Floriantoine/SPY-BOT/docs/img/rendu-3d.png

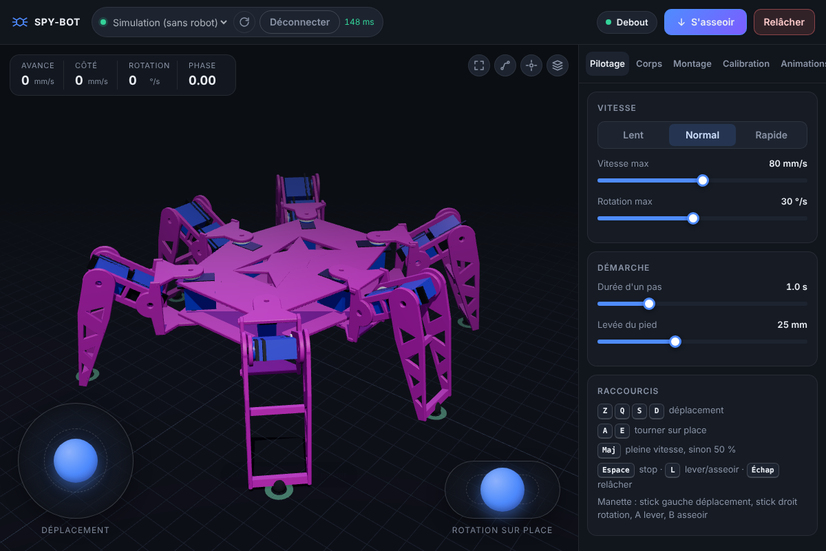
docs/img/rendu-3d.png
