Floriantoine/SPY-BOT/pc/web/models/corps.stl

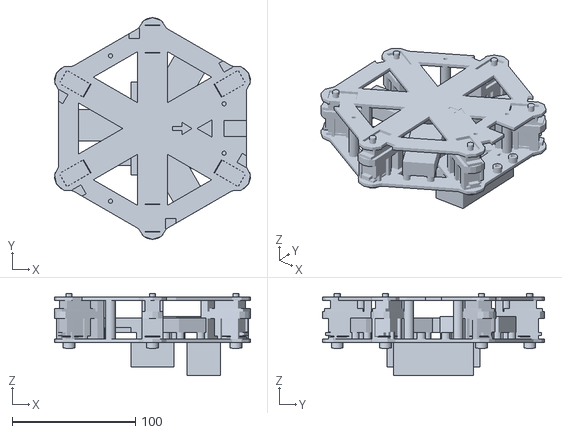
[picture p3: CAD file, 2026-11-03]
pc/web/models/corps.stl
158.8 x 179.8 x 66.6
