Floriantoine/SPY-BOT/pc/web/models/tibia.stl

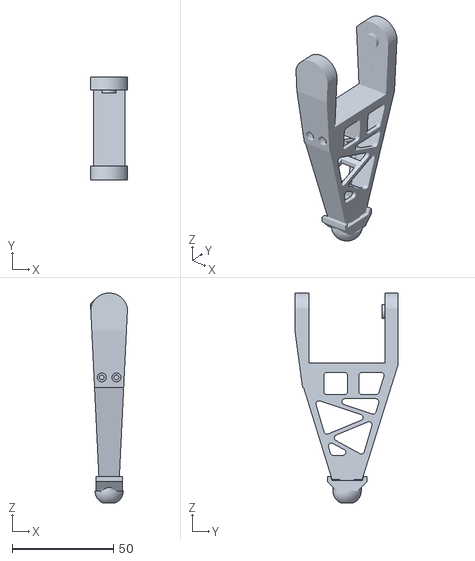
[picture p4: CAD file, 2026-11-02]
pc/web/models/tibia.stl
18.3 x 51.0 x 103.7
