Floriantoine/SPY-BOT/pc/web/models/coxa.stl

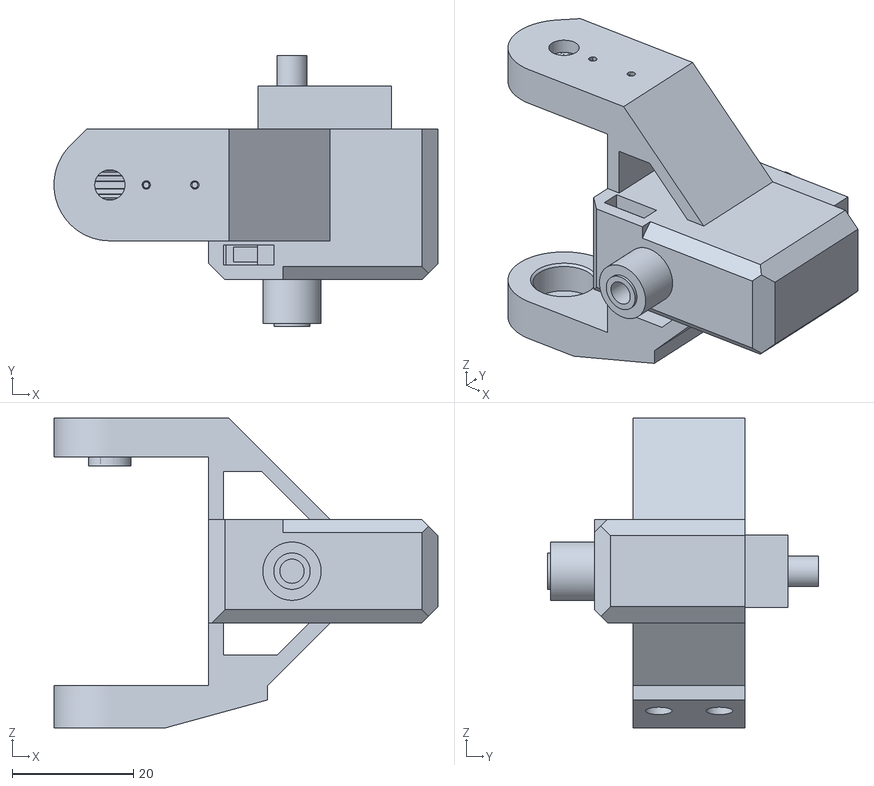
[picture p5: CAD file, 2026-11-02]
pc/web/models/coxa.stl
63.2 x 44.6 x 51.0
