Floriantoine/SPY-BOT/pc/web/models/femur.stl

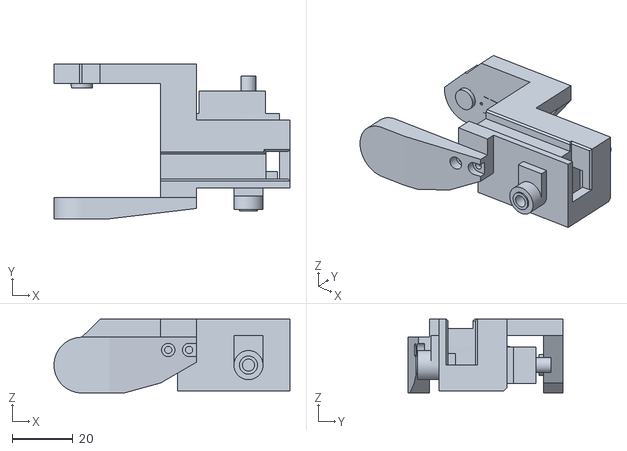
[picture p6: CAD file, 2026-11-02]
pc/web/models/femur.stl
77.9 x 51.0 x 24.4
