Floriantoine/SPY-BOT/docs/img/calibration.png

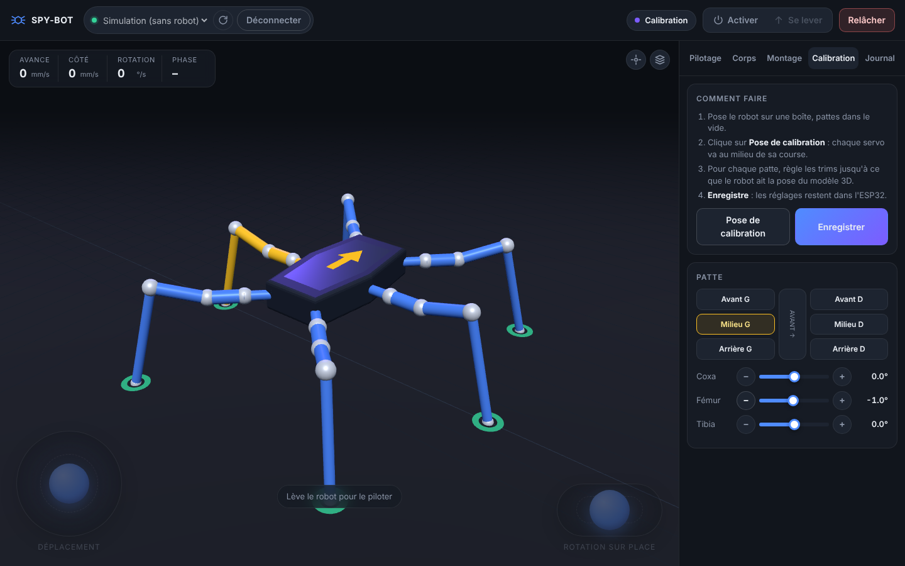
docs/img/calibration.png
