Floriantoine/SPY-BOT/firmware_c/src/robot.cpp

#include "robot.h"

#include <math.h>
#include <stdio.h>
#include <string.h>

#include "pyfmt.h"

// =============================================================================
// Servos et pattes (config.py, servo.py, robot._joint)
// =============================================================================

Leg g_legs[NLEGS];

void JointServo::refresh() {
    // robot._joint : d = 90 + direction × (deg - zéro) + trim, borné à [min, max] ± marge.
    double u = (min_deg + SERVO_MARGIN - 90.0 - trim_deg) / direction + zero_deg;
    double w = (max_deg - SERVO_MARGIN - 90.0 - trim_deg) / direction + zero_deg;
    lo_rad = (pymin(u, w) - 1e-9) / DEG_PER_RAD;
    hi_rad = (pymax(u, w) + 1e-9) / DEG_PER_RAD;
    k7 = 90.0 - direction * zero_deg + trim_deg;
    k8 = direction * DEG_PER_RAD;
    k9 = us_per_deg / US_PER_DEG - 1.0;
    k10 = 90.0 + trim_deg;
}

void legs_init() {
    for (int i = 0; i < NLEGS; i++) {
        Leg& leg = g_legs[i];
        leg.def = &CFG_LEGS[i];
        for (int j = 0; j < 3; j++) {
            const JointDef& d = CFG_LEGS[i].joint[j];
            JointServo& s = leg.joint[j];
            s.board = d.board;
            s.channel = d.channel;
            s.zero_deg = d.zero_deg;
            s.default_direction = s.direction = d.direction;
            s.trim_deg = 0.0;
            s.trim_is_int = false;
            s.min_deg = d.min_deg;
            s.max_deg = d.max_deg;
            s.us_per_deg = US_PER_DEG;
            s.refresh();
        }
    }
}

int leg_index(const char* name) {
    for (int i = 0; i < NLEGS; i++)
        if (strcmp(CFG_LEGS[i].name, name) == 0) return i;
    return -1;
}

double ik_to_servo_deg(double angle_rad, const JointServo& j) {
    double deg = 90.0 + j.direction * (angle_rad * SERVO_DEG_PER_RAD - j.zero_deg) + j.trim_deg;
    deg = pymax(j.min_deg, pymin(j.max_deg, deg));
    // Course réelle du servo : l'écart à la pose de calibration est mis à l'échelle.
    if (j.us_per_deg != US_PER_DEG) deg = deg + (deg - 90.0 - j.trim_deg) * (j.us_per_deg / US_PER_DEG - 1.0);
    return deg;
}

// =============================================================================
// Sauts de consigne adoucis (servo.py)
// =============================================================================

void soft_step(double e0, double w, double accel, double dt, double* e1, double* w1) {
    double d = e0 > 0.0 ? e0 : -e0;
    double s = e0 > 0.0 ? -1.0 : 1.0;
    double wd = w * s;  // vitesse d'approche en cours
    if (wd < 0.0) wd = 0.0;
    double cap = wd + accel * dt;
    double h = accel * dt / 2;
    double vc = sqrt(h * h + 2 * accel * d) - h;  // au-delà, plus moyen de freiner à temps
    double lin = d / dt;
    if (lin <= vc && lin <= cap) {
        *e1 = 0.0;  // arrivé à ce tick
        *w1 = s * lin;
        return;
    }
    *w1 = s * (vc < cap ? vc : cap);
    *e1 = e0 + *w1 * dt;
}

SmoothDriver::SmoothDriver(ServoDriver* inner)
    : accel(SLEW_DEG), busy(false), inner_(inner), walking_(false), fresh_(false) {
    memset(ch_, 0, sizeof(ch_));
}

void SmoothDriver::set_angle(int board, int channel, double deg) {
    Chan& c = ch_[board][channel];
    if (!c.valid) {
        // Position de départ inconnue (servo relâché) : rien à adoucir.
        c.x = c.p = c.xp = deg;
        c.w = 0.0;
        c.fresh = false;
        c.valid = true;
        inner_->set_angle(board, channel, deg);
        return;
    }
    c.x = deg;
    c.fresh = true;
    fresh_ = true;
}

bool SmoothDriver::lag(int board, int channel, double* p) const {
    const Chan& c = ch_[board][channel];
    if (!c.valid || c.p == c.x) return false;
    *p = c.p;
    return true;
}

void SmoothDriver::relax() {
    memset(ch_, 0, sizeof(ch_));
    busy = fresh_ = false;
    inner_->relax();
}

void SmoothDriver::flush(double dt, bool walking) {
    bool turn = walking != walking_;
    walking_ = walking;
    if (dt <= 0.0 || !(fresh_ || busy)) return;
    fresh_ = false;
    bool batch = inner_->has_batch();
    bool any = false;
    for (int b = 0; b < CFG_NBOARDS; b++) {
        bool dirty = false;
        for (int n = 0; n < 16; n++) {
            Chan& c = ch_[b][n];
            if (!c.valid) continue;
            double x = c.x, p = c.p, w = c.w, xp = c.xp;
            if (!c.fresh && p == x && w == 0.0) continue;  // sur sa consigne, qui n'a pas changé
            c.fresh = false;
            if (turn && w != 0.0) {
                double vt = (x - xp) / dt;
                w = walking ? w - vt : w + vt;
            }
            double e0 = walking ? p - xp : p - x;
            if (accel <= 0.0 || e0 == 0.0) {
                p = x;
                w = 0.0;
            } else {
                soft_step(e0, w, accel, dt, &e0, &w);
                p = x + e0;
            }
            if (p != x || w != 0.0) any = true;
            c.p = p;
            c.w = w;
            c.xp = x;
            dirty = true;
            if (!batch) inner_->set_angle(b, n, p);
        }
        if (dirty && batch) {
            // Voies qui se suivent : une seule écriture I²C.
            int start = -1, len = 0;
            double run[16];
            for (int n = 0; n < 16; n++) {
                if (!ch_[b][n].valid) continue;
                if (len && n != start + len) {
                    inner_->set_angles(b, start, run, len);
                    len = 0;
                }
                if (!len) start = n;
                run[len++] = ch_[b][n].p;
            }
            if (len) inner_->set_angles(b, start, run, len);
        }
    }
    busy = any;
}

// =============================================================================
// Cinématique inverse (leg_ik.py)
// =============================================================================

static char g_unreachable[96];

const char* unreachable_message() { return g_unreachable; }

bool leg_ik(double x, double y, double z, LegAngles* out) {
    static const double c = CFG_COXA, f = CFG_FEMUR, t = CFG_TIBIA;
    static const double k3 = f + t, k4 = fabs(f - t), k5 = f * f + t * t, k6 = 2 * f * t, k7 = f * f - t * t,
                        k8 = 2 * f;
    double r = sqrt(x * x + y * y) - c;
    double dd = r * r + z * z;
    double d = sqrt(dd);
    if (d > k3 || d < k4 || d == 0) {
        snprintf(g_unreachable, sizeof(g_unreachable), "pied hors de portée : (%.1f, %.1f, %.1f), d=%.1f", x, y, z, d);
        return false;
    }
    double cos_knee = (k5 - dd) / k6;
    double cos_shoulder = (k7 + dd) / (k8 * d);
    cos_knee = cos_knee < -1.0 ? -1.0 : cos_knee > 1.0 ? 1.0 : cos_knee;
    cos_shoulder = cos_shoulder < -1.0 ? -1.0 : cos_shoulder > 1.0 ? 1.0 : cos_shoulder;
    out->coxa = atan2(y, x);
    out->femur = atan2(z, r) + acos(cos_shoulder);
    out->tibia = acos(cos_knee) - PY_PI;
    return true;
}

// tibia_fold_limit - FOLD_MARGIN, en radians (robot._fold_limit_rad).
static double fold_limit_rad(double femur, bool middle) {
    double f0 = FOLD_RAD[0][0], t0 = FOLD_RAD[0][1];
    double v;
    if (femur <= f0) {
        v = t0;
    } else {
        v = FOLD_RAD[FOLD_POINTS - 1][1];
        for (int i = 1; i < FOLD_POINTS; i++) {
            double f1 = FOLD_RAD[i][0], t1 = FOLD_RAD[i][1];
            if (femur <= f1) {
                v = t0 + (t1 - t0) * (femur - f0) / (f1 - f0);
                break;
            }
            f0 = f1;
            t0 = t1;
        }
    }
    if (femur <= BATTERY_RAD[0] && v > BATTERY_RAD[1]) v = BATTERY_RAD[1];
    if (middle && femur <= STRAP_RAD[0] && v > STRAP_RAD[1]) v = STRAP_RAD[1];
    return v;
}

double leg_margin(const Leg& leg, const LegAngles& a) {
    const JointServo* c = &leg.joint[0];
    double worst = a.coxa - c->lo_rad;
    double v = c->hi_rad - a.coxa;
    if (v < worst) worst = v;
    c = &leg.joint[1];
    v = a.femur - c->lo_rad;
    if (v < worst) worst = v;
    v = c->hi_rad - a.femur;
    if (v < worst) worst = v;
    c = &leg.joint[2];
    v = a.tibia - c->lo_rad;
    if (v < worst) worst = v;
    v = c->hi_rad - a.tibia;
    if (v < worst) worst = v;
    double fold = fold_limit_rad(a.femur, leg.def->middle) + a.tibia + K_HALF_PI;
    worst = worst * DEG_PER_RAD + SERVO_MARGIN;
    fold = fold * DEG_PER_RAD + FOLD_MARGIN;
    return fold < worst ? fold : worst;
}

bool leg_ok(const Leg& leg, const LegAngles& a) {
    const JointServo* c = &leg.joint[0];
    double v = a.coxa;
    if (v < c->lo_rad || v > c->hi_rad) return false;
    c = &leg.joint[1];
    double femur = a.femur;
    if (femur < c->lo_rad || femur > c->hi_rad) return false;
    c = &leg.joint[2];
    v = a.tibia;
    if (v < c->lo_rad || v > c->hi_rad) return false;
    if (femur <= K_MINUS_HALF_PI || -v - K_HALF_PI > fold_limit_rad(femur, leg.def->middle)) return false;
    // Fémur levé : la coxa doit moins tourner (bord de la plaque du haut).
    return femur <= RAD_45 || fabs(a.coxa) <= RAD_55 - (femur - RAD_45) / 3.0;
}

bool neighbours_ok(const AngleSet& angles) {
    for (int i = 0; i < NLEGS; i++) {
        int n = CFG_AROUND[i], m = CFG_AROUND[(i + 1) % NLEGS];
        if ((angles.leg[n].coxa - angles.leg[m].coxa) * DEG_PER_RAD > NEIGHBOUR_LIMIT) return false;
    }
    return true;
}

// =============================================================================
// Corps (body_ik.py)
// =============================================================================

struct Rot {
    double m[3][3];
};

static Rot rotation(double roll, double pitch, double yaw) {
    double cr = cos(roll), sr = sin(roll);
    double cp = cos(pitch), sp = sin(pitch);
    double cy = cos(yaw), sy = sin(yaw);
    Rot r = {{{cy * cp, cy * sp * sr - sy * cr, cy * sp * cr + sy * sr},
              {sy * cp, sy * sp * sr + cy * cr, sy * sp * cr - cy * sr},
              {-sp, cp * sr, cp * cr}}};
    return r;
}

// Pied dans le repère du corps déplacé (foot_in_body), puis de la patte (body_to_leg_frame).
static void foot_to_leg(const double foot[3], const BodyPose& pose, const Rot& r, int leg, double out[3]) {
    double dx = foot[0] - pose.x, dy = foot[1] - pose.y, dz = foot[2] - pose.z;
    double bx = r.m[0][0] * dx + r.m[1][0] * dy + r.m[2][0] * dz;
    double by = r.m[0][1] * dx + r.m[1][1] * dy + r.m[2][1] * dz;
    double bz = r.m[0][2] * dx + r.m[1][2] * dy + r.m[2][2] * dz;
    const LegDef& d = CFG_LEGS[leg];
    double ex = bx - d.mount_x, ey = by - d.mount_y;
    double c = d.cos_a, s = d.sin_a;
    out[0] = c * ex + s * ey;
    out[1] = -s * ex + c * ey;
    out[2] = bz;
}

// =============================================================================
// Réserve d'AngleSet
// =============================================================================

AngleSet* AnglePool::alloc() {
    for (int i = 0; i < SLOTS; i++) {
        bool used = false;
        for (int h = 0; h < nholders_ && !used; h++) used = *holders_[h] == &slots_[i];
        if (!used) return &slots_[i];
    }
    return &slots_[0];  // n'arrive pas : moins de détenteurs que de cases
}

// =============================================================================
// Démarches (gait.py)
// =============================================================================

void TripodGait::advance(double dt, bool moving) {
    double new_phase = phase + dt / period;
    if (!moving) {
        if (at_rest()) return;
        new_phase = pymin(new_phase, phase < 0.5 ? 0.5 : 1.0);
    }
    phase = pymod(new_phase, 1.0);
}

double TripodGait::swing(int leg) const {
    double p = CFG_LEGS[leg].tripod_a ? phase : pymod(phase + 0.5, 1.0);
    return p < 0.5 ? p / 0.5 : -1.0;
}

double TripodGait::time_to_lift(int leg) const {
    double p = CFG_LEGS[leg].tripod_a ? phase : pymod(phase + 0.5, 1.0);
    return (1.0 - p) * period;
}

bool WaveGait::at_rest() const {
    double q = phase * 6;
    return fabs(q - (double)pyround(q)) < 1e-9;
}

void WaveGait::advance(double dt, bool moving) {
    if (!moving && at_rest()) return;
    double new_phase = phase + dt / period;
    if (!moving) {
        // Arrêt au prochain sixième : tous les pieds au sol.
        new_phase = pymin(new_phase, (double)((long long)(phase * 6 + 1e-9) + 1) / 6.0);
    }
    phase = pymod(new_phase, 1.0);
    if (fabs(phase - 1.0) < 1e-9) phase = 0.0;
}

double WaveGait::swing(int leg) const {
    double w = swing_part();
    double u = pymod(phase - (double)CFG_LEGS[leg].wave_rank / 6, 1.0);
    return u < w - 1e-9 ? u / w : -1.0;
}

double WaveGait::time_to_lift(int leg) const {
    double u = pymod(phase - (double)CFG_LEGS[leg].wave_rank / 6, 1.0);
    return (1.0 - u) * period;
}

double QuadGait::swing_part() const { return (1.0 - QUAD_SHIFT) / 4; }

bool QuadGait::at_rest() const {
    double q = phase * 4;
    return fabs(q - (double)pyround(q)) < 1e-9;
}

void QuadGait::reset() {
    phase = 0.0;
    slot = 0;
    has_target = false;
    shift_x = shift_y = from_x = from_y = 0.0;
}

void QuadGait::advance(double dt, bool moving) {
    if (!moving && at_rest()) {
        // Arrêté : le corps revient doucement au centre, pieds au sol.
        double step = 60.0 * dt;
        double x = shift_x, y = shift_y;
        double n = sqrt(x * x + y * y);
        double k = n != 0.0 ? pymax(0.0, n - step) / n : 0.0;
        shift_x = from_x = x * k;
        shift_y = from_y = y * k;
        return;
    }
    double new_phase = phase + dt / period;
    if (!moving) {
        // Arrêt au prochain quart : tous les pieds au sol.
        new_phase = pymin(new_phase, (double)((long long)(phase * 4 + 1e-9) + 1) / 4.0);
    }
    phase = pymod(new_phase, 1.0);
    if (fabs(phase - 1.0) < 1e-9) phase = 0.0;
    int s = (int)((long long)(phase * 4 + 1e-9) % 4);
    if (s != slot || !has_target) {
        slot = s;
        from_x = shift_x;
        from_y = shift_y;
        planner->plan_sway(s, &target_x, &target_y);
        has_target = true;
    }
    double u = pymin(1.0, pymax(0.0, phase * 4 - s));
    if (u < QUAD_SHIFT) {
        double q = u / QUAD_SHIFT;
        q = q * q * (3 - 2 * q);
        shift_x = from_x + (target_x - from_x) * q;
        shift_y = from_y + (target_y - from_y) * q;
    } else {
        shift_x = target_x;
        shift_y = target_y;
    }
}

double QuadGait::swing(int leg) const {
    int idx = CFG_LEGS[leg].quad_rank;
    if (idx < 0) return -1.0;  // patte repliée : gérée par Hexapod
    double w = swing_part();
    double u = pymod(phase - (idx + QUAD_SHIFT) / 4, 1.0);
    return u < w - 1e-9 ? u / w : -1.0;
}

double QuadGait::time_to_lift(int leg) const {
    double u = pymod(phase - (CFG_LEGS[leg].quad_rank + QUAD_SHIFT) / 4, 1.0);
    return (1.0 - u) * period;
}

// =============================================================================
// PROF
// =============================================================================

const char* const PROF_NAMES[PROF_PARTS] = {"capteur", "gyro", "i2c", "ik", "pieds", "place", "servos", "telem", "tick", "update"};
Profiler g_prof;

void Profiler::add(int part, unsigned long t0) {
    us[part] += platform_micros() - t0;
    used[part] = true;
}

struct ProfScope {
    int part;
    unsigned long t0;
    explicit ProfScope(int p) : part(p), t0(g_prof.on ? platform_micros() : 0) {}
    ~ProfScope() {
        if (g_prof.on) g_prof.add(part, t0);
    }
};

// =============================================================================
// Hexapod (robot.py)
// =============================================================================

static double py_sq(double v) { return pow(v, 2.0); }  // v ** 2 de Python

static double rate(double value, double target, double accel, double decel) {
    // Freinage (vers zéro, ou changement de sens) plus fort que l'accélération.
    return (value * target > 0 && fabs(target) > fabs(value)) ? accel : (value != 0.0 ? decel : accel);
}

static double approach(double value, double target, double step) {
    if (value < target) return pymin(target, value + step);
    return pymax(target, value - step);
}

static double fraction_inside(double x, double y, double mx, double my, double radius) {
    if (py_sq(x + mx) + py_sq(y + my) <= radius * radius) return 1.0;
    double a = mx * mx + my * my;
    double b = 2 * (x * mx + y * my);
    double c = x * x + y * y - radius * radius;
    if (c >= 0) return b <= 0 ? 1.0 : 0.0;
    return pymax(0.0, pymin(1.0, (-b + sqrt(b * b - 4 * a * c)) / (2 * a)));
}

Hexapod::Hexapod(ServoDriver* d, AnglePool* p) : driver(d), pool(p) {
    tripod.period = GAIT_PERIOD;
    tripod.step_height = TRIPOD_STEP_HEIGHT;
    tripod.max_stride = TRIPOD_MAX_STRIDE;
    tripod.phase = 0.0;
    tripod.shift_x = tripod.shift_y = 0.0;
    for (int i = 0; i < NLEGS; i++) {
        neutral[i][0] = CFG_LEGS[i].neutral_x;
        neutral[i][1] = CFG_LEGS[i].neutral_y;
        neutral[i][2] = CFG_LEGS[i].neutral_z;
    }
    // À 4 pattes, le corps se balance en plus du pas (réglages de robot.py).
    gait4.period = QUAD_PERIOD;
    gait4.step_height = QUAD_STEP_HEIGHT;
    gait4.max_stride = QUAD_MAX_STRIDE;
    gait4.sway = QUAD_SWAY;
    gait4.planner = this;
    gait4.target_x = gait4.target_y = 0.0;
    gait4.reset();
    // Vague : chaque patte fait son pas à tour de rôle, cycle deux fois plus long.
    wave.period = WAVE_PERIOD;
    wave.step_height = TRIPOD_STEP_HEIGHT;
    wave.max_stride = TRIPOD_MAX_STRIDE;
    wave.phase = 0.0;
    wave.shift_x = wave.shift_y = 0.0;
    wave_mode = WAVE_OFF;
    wave_speed = WAVE_SPEED;
    wave_key_valid_ = false;
    wave_shift = shift_mm_ = WAVE_SHIFT;
    shift_amp_ = 0.0;
    shift_dir_[0] = shift_dir_[1] = 0.0;
    sag = SAG_DEG;
    sag_rad = SAG_DEG * DEG;
    sag_k = 1.0;
    for (int i = 0; i < NLEGS; i++) load[i] = 1.0;
    load_settled_ = true;
    six = &tripod;
    gait = &tripod;
    legs = 6;
    tuck = 0.0;
    command = current = gait_command();
    pose = base_pose = applied = body_pose();
    pose_scale = lift_scale = 1.0;
    memset(offsets, 0, sizeof(offsets));
    memset(lift_, 0, sizeof(lift_));
    memset(has_lift_, 0, sizeof(has_lift_));
    rest_key_valid_ = false;
    rest_key_gait_ = NULL;
    rest_key_legs_ = 0;
    rest_key_phase_ = 0.0;
    memset(ground, 0, sizeof(ground));
    memset(ground_lift_, 0, sizeof(ground_lift_));
    memset(has_ground_lift_, 0, sizeof(has_ground_lift_));
    memset(touched_, 0, sizeof(touched_));
    feel_rate[0] = feel_rate[1] = 0.0;
    last_angles = written = NULL;
    solve_key_valid = false;
    feel_ground = false;
    time_scale = 1.0;
    travel[0] = travel[1] = travel[2] = 0.0;
    for (int i = 0; i < NLEGS; i++) {
        double dx = neutral[i][0] - CFG_LEGS[i].mount_x, dy = neutral[i][1] - CFG_LEGS[i].mount_y;
        double dd = sqrt(dx * dx + dy * dy);
        radial_[i][0] = dx / dd;
        radial_[i][1] = dy / dd;
    }
    reach_table(0);
    for (int i = 0; i < NLEGS; i++) home_target_[i] = home_margin(i, body_pose(), 0.0);
    home_wait_ = 0.0;
    memset(placed_, 0, sizeof(placed_));
    replace_feet = true;
    memset(home, 0, sizeof(home));
    memset(home_goal, 0, sizeof(home_goal));
    memset(home_key_, 0, sizeof(home_key_));
    home_checked_valid_ = false;
    home_checked_legs_ = 0;
    reach_cache_valid_ = false;
    reach_cache_gait_ = NULL;
    memset(halves_, 0, sizeof(halves_));
    pool->hold(&last_angles);
    pool->hold(&written);
}

int Hexapod::set_legs(int n) {
    if (n != 4 && n != 6) return 1;
    if (n == legs) return 0;
    if (!(command.is_zero() && at_rest())) return 2;
    legs = n;
    gait = n == 4 ? (Gait*)&gait4 : six;
    // Les pieds restent où ils sont (posés, à moins de STOP_TOL de leur place).
    gait->reset();
    gait->shift_x = gait->shift_y = 0.0;
    shift_amp_ = 0.0;
    current = gait_command();
    memset(has_lift_, 0, sizeof(has_lift_));
    memset(placed_, 0, sizeof(placed_));
    rest_key_valid_ = false;
    return 0;
}

void Hexapod::reset_gait() {
    gait->reset();
    gait->shift_x = gait->shift_y = 0.0;
    shift_amp_ = 0.0;
    for (int i = 0; i < NLEGS; i++) load[i] = 1.0;
    load_settled_ = true;
    current = gait_command();
    memset(offsets, 0, sizeof(offsets));
    memset(has_lift_, 0, sizeof(has_lift_));
    memset(placed_, 0, sizeof(placed_));
    rest_key_valid_ = false;
    memset(home, 0, sizeof(home));
    memset(home_goal, 0, sizeof(home_goal));
    memset(home_key_, 0, sizeof(home_key_));
    home_checked_valid_ = false;
    reach_cache_valid_ = false;
    forget_ground();
}

void Hexapod::forget_ground() {
    memset(ground, 0, sizeof(ground));
    memset(has_ground_lift_, 0, sizeof(has_ground_lift_));
    memset(touched_, 0, sizeof(touched_));
    feel_rate[0] = feel_rate[1] = 0.0;
}

void Hexapod::feel(double dt, double roll_rate, double pitch_rate) {
    // Devine au gyroscope où le sol n'est pas à la hauteur prévue (robot.feel).
    if (!feel_ground) return;
    double fr = feel_rate[0], fp = feel_rate[1];
    double k = dt != 0.0 ? pymin(1.0, dt / FEEL_SMOOTH) : 1.0;
    roll_rate = fr + (roll_rate - fr) * k;
    pitch_rate = fp + (pitch_rate - fp) * k;
    feel_rate[0] = roll_rate;
    feel_rate[1] = pitch_rate;
    const Gait& g = *gait;
    int push = -1, sink = -1;
    double push_score = 0.0, sink_score = 0.0;
    for (int n = 0; n < NLEGS; n++) {
        if (!walking(n)) continue;
        double x = neutral[n][0], y = neutral[n][1];
        // > 0 : le coin de ce pied monte.
        double score = (roll_rate * y - pitch_rate * x) / sqrt(x * x + y * y);
        double s = g.swing(n);
        if (s >= 0.0 && s > TOUCH_FROM && !touched_[n]) {
            if (score > TOUCH_RATE && (push < 0 || score > push_score)) {
                push = n;
                push_score = score;
            }
        } else if (s < 0.0 && g.time_to_lift(n) > (1.0 - SINK_WINDOW) * g.stance_time()) {
            if (score < -TOUCH_RATE && (sink < 0 || score < sink_score)) {
                sink = n;
                sink_score = score;
            }
        }
    }
    if (push >= 0) {
        int n = push;
        double dz = offsets[n][2];
        double z = ground[n] + lift_scale * dz;  // là où est vraiment le pied
        if (z <= GROUND_MAX) {
            touched_[n] = true;
            ground[n] = z;
            offsets[n][2] = 0.0;
        }
    }
    if (sink >= 0) ground[sink] = pymax(-GROUND_MAX, ground[sink] - EXTEND_SPEED * dt);
}

bool Hexapod::at_rest() const {
    double sx = gait->shift_x, sy = gait->shift_y;  // 4 pattes : corps revenu au centre
    return current.is_zero() && gait->at_rest() && sx * sx + sy * sy < 0.25 && feet_settled();
}

bool Hexapod::still() const {
    double sx = gait->shift_x, sy = gait->shift_y;
    return current.is_zero() && gait->at_rest() && load_settled_ && sx * sx + sy * sy < 0.25;
}

BodyPose Hexapod::effective_pose(double scale) const {
    const BodyPose &b = base_pose, &p = pose;
    if (scale == 1.0) return p;
    return body_pose(b.x + scale * (p.x - b.x), b.y + scale * (p.y - b.y), b.z + scale * (p.z - b.z),
                     b.roll + scale * (p.roll - b.roll), b.pitch + scale * (p.pitch - b.pitch),
                     b.yaw + scale * (p.yaw - b.yaw));
}

// solve(pose, lift, check) : sans contrôle (check=None) quand `checked` est faux.
// Retourne 1 si réussi, 0 si une patte ne passe pas le contrôle, -1 si hors de portée.
static int solve_impl(const Hexapod& h, const BodyPose& pose, double lift, bool checked, AngleSet* out) {
    Rot R = rotation(pose.roll, pose.pitch, pose.yaw);
    double sx = h.gait->shift_x, sy = h.gait->shift_y;
    double bx = sx + pose.x, by = sy + pose.y, bz = pose.z;
    double tuck = h.tuck;
    double sag = h.sag_rad * h.sag_k;
    for (int i = 0; i < NLEGS; i++) {
        const double* p = h.neutral[i];
        const double* o = h.offsets[i];
        double dx = p[0] + o[0] - bx;
        double dy = p[1] + o[1] - by;
        double dz = p[2] + lift * o[2] + h.ground[i] - bz;
        double fx = R.m[0][0] * dx + R.m[1][0] * dy + R.m[2][0] * dz;
        double fy = R.m[0][1] * dx + R.m[1][1] * dy + R.m[2][1] * dz;
        double fz = R.m[0][2] * dx + R.m[1][2] * dy + R.m[2][2] * dz;
        const LegDef& d = CFG_LEGS[i];
        double w = h.load[i];
        if (tuck > 0.0 && d.tucked) {
            double k = tuck * tuck * (3 - 2 * tuck);
            fx = fx + (d.tuck_x - fx) * k;
            fy = fy + (d.tuck_y - fy) * k;
            fz = fz + (d.tuck_z - fz) * k;
            w = w * (1.0 - k);  // repliée : elle ne porte pas
        }
        double ca = d.cos_a, sa = d.sin_a;
        double ex = fx - d.mount_x, ey = fy - d.mount_y;
        if (!leg_ik(ca * ex + sa * ey, ca * ey - sa * ex, fz, &out->leg[i])) return -1;
        if (sag != 0.0) out->leg[i].femur -= sag * w;  // la patte qui porte pousse un peu plus
        if (checked && !leg_ok(g_legs[i], out->leg[i])) return 0;
    }
    return 1;
}

bool Hexapod::solve(const BodyPose& p, double lift, AngleSet* out) { return solve_impl(*this, p, lift, false, out) == 1; }

bool Hexapod::solve_checked(const BodyPose& p, double lift, AngleSet* out) {
    return solve_impl(*this, p, lift, true, out) == 1;
}

bool Hexapod::try_(double scale, double lift, AngleSet* out) {
    return solve_checked(effective_pose(scale), lift, out) && neighbours_ok(*out);
}

bool Hexapod::update(double dt, AngleSet** out) {
    ProfScope prof(PROF_UPDATE);
    double goal = legs == 4 ? 1.0 : 0.0;
    double step = dt / TUCK_TIME;
    tuck = goal > tuck ? pymin(goal, tuck + step) : pymax(goal, tuck - step);
    // Pas de marche tant que les pattes du milieu bougent.
    GaitCommand target = tuck_settled() ? command : gait_command();
    Gait* want = legs == 6 ? wanted_gait() : gait;
    double top = 0.0;
    if (want == &wave && gait != want) {
        // Tripode -> vague : la vague ne va pas aussi vite. Le robot ralentit
        // d'abord à ce qu'elle sait faire, puis change.
        top = WAVE_ENTER * want->max_stride / want->stance_time();
        double v = foot_speed(target);
        if (v > top) {
            double k = top / v;
            target = gait_command(target.vx * k, target.vy * k, target.yaw_rate * k);
        }
    }
    GaitCommand c = current;
    // En vague, la consigne change 3 fois moins vite (appui 3 fois plus long).
    double adt = gait == &wave ? dt * WAVE_ACCEL : dt;
    current = gait_command(approach(c.vx, target.vx, rate(c.vx, target.vx, ACCEL, DECEL) * adt),
                           approach(c.vy, target.vy, rate(c.vy, target.vy, ACCEL, DECEL) * adt),
                           approach(c.yaw_rate, target.yaw_rate,
                                    rate(c.yaw_rate, target.yaw_rate, YAW_ACCEL, YAW_DECEL) * adt));
    sag_rad = approach(sag_rad, sag * DEG, SAG_SLEW * DEG * dt);
    home_wait_ -= dt;
    if (home_wait_ <= 0.0) {
        bool changed;
        {
            ProfScope pp(PROF_PLACE);
            changed = refresh_home();
        }
        if (changed) home_wait_ = HOME_PERIOD;
    }
    // Démarche ralentie si le corps bascule trop vite (gyroscope).
    double gdt = dt * time_scale;
    bool moving = !(current.is_zero() && feet_settled());
    if (want != gait && (top == 0.0 || foot_speed(current) <= 1.05 * top)) {
        // Tripode <-> vague : seulement à un instant où les 6 pieds sont posés.
        // En marche, la démarche s'arrête à cet instant, puis l'autre repart de là.
        if (gait->at_rest())
            switch_gait(want);
        else
            moving = false;
    }
    gait->advance(gdt, moving);
    if (gait != &gait4) wave_sway(dt, moving);
    {
        ProfScope pp(PROF_PIEDS);
        move_feet(gdt);
    }
    bool unreachable = false;
    AngleSet* angles;
    {
        ProfScope pp(PROF_IK);
        angles = solve_limited(dt, &unreachable);
    }
    if (unreachable) return false;
    if (angles != written) {  // mêmes angles qu'au tick d'avant : déjà envoyés
        ProfScope pp(PROF_SERVOS);
        write_servos(*angles);
        written = angles;
    }
    *out = angles;
    return true;
}

AngleSet* Hexapod::solve_limited(double dt, bool* unreachable) {
    double s = pose_scale, l = lift_scale;
    double rs = pymin(1.0, s + POSE_RECOVER * dt), rl = pymin(1.0, l + POSE_RECOVER * dt);
    const BodyPose &p = pose, &b = base_pose;
    double key[KEY_LEN];
    int k = 0;
    for (int i = 0; i < NLEGS; i++)
        for (int j = 0; j < 3; j++) key[k++] = offsets[i][j];
    for (int i = 0; i < NLEGS; i++) key[k++] = ground[i];
    key[k++] = gait->shift_x;
    key[k++] = gait->shift_y;
    key[k++] = tuck;
    key[k++] = legs;
    const double rest[] = {p.x, p.y, p.z, p.roll, p.pitch, p.yaw, b.x, b.y, b.z, b.roll, b.pitch, b.yaw, s, l, rs, rl,
                           sag_rad, sag_k};
    for (int i = 0; i < 18; i++) key[k++] = rest[i];
    for (int i = 0; i < NLEGS; i++) key[k++] = load[i];
    if (solve_key_valid && last_angles != NULL) {
        bool same = true;
        for (int i = 0; i < KEY_LEN && same; i++) same = key[i] == solve_key_[i];
        if (same) return last_angles;
    }
    AngleSet work;
    bool found = false;
    double fs = 0.0, fl = 0.0;
    double tried[4][2];
    int ntried = 0;
    const double cands[4][2] = {{rs, rl}, {rs, l}, {s, l}, {s, pymax(LIFT_MIN, l - LIFT_STEP)}};
    for (int c = 0; c < 4; c++) {
        double cs = cands[c][0], cl = cands[c][1];
        bool seen = false;
        for (int t = 0; t < ntried; t++) seen = seen || (tried[t][0] == cs && tried[t][1] == cl);
        if (seen) continue;
        tried[ntried][0] = cs;
        tried[ntried][1] = cl;
        ntried++;
        if (try_(cs, cl, &work)) {
            found = true;
            fs = cs;
            fl = cl;
            break;
        }
    }
    if (!found) found = search(rs, rl, &fs, &fl, &work);
    if (!found) {
        // Même sans pose et sans lever les pieds, c'est trop : derniers angles valides.
        if (last_angles != NULL) return last_angles;
        pose_scale = lift_scale = 1.0;
        applied = pose;
        AngleSet* out = pool->alloc();
        if (!solve(pose, 1.0, out)) {
            *unreachable = true;
            return NULL;
        }
        return out;
    }
    pose_scale = fs;
    lift_scale = fl;
    applied = effective_pose(pose_scale);
    AngleSet* out = pool->alloc();
    *out = work;
    last_angles = out;
    solve_key_valid = (rs == fs && rl == fl);
    if (solve_key_valid) memcpy(solve_key_, key, sizeof(key));
    return out;
}

bool Hexapod::search(double top_s, double top_l, double* s_out, double* l_out, AngleSet* out) {
    // _bisect(lambda v: _try(v, LIFT_MIN), top_s)
    AngleSet best, a;
    double s;
    if (try_(top_s, LIFT_MIN, &best)) {
        s = top_s;
    } else {
        double lo = 0.0, hi = top_s;
        if (!try_(0.0, LIFT_MIN, &best)) return false;
        for (int i = 0; i < BISECT; i++) {
            double mid = (lo + hi) / 2;
            if (!try_(mid, LIFT_MIN, &a)) {
                hi = mid;
            } else {
                lo = mid;
                best = a;
            }
        }
        s = lo;
    }
    // _bisect(lambda v: _try(s, LIFT_MIN + (1 - LIFT_MIN) * v), (top_l - LIFT_MIN) / (1 - LIFT_MIN), angles)
    double top = (top_l - LIFT_MIN) / (1.0 - LIFT_MIN);
    double v;
    if (try_(s, LIFT_MIN + (1.0 - LIFT_MIN) * top, &a)) {
        v = top;
        best = a;
    } else {
        double lo = 0.0, hi = top;
        for (int i = 0; i < BISECT; i++) {
            double mid = (lo + hi) / 2;
            if (!try_(s, LIFT_MIN + (1.0 - LIFT_MIN) * mid, &a)) {
                hi = mid;
            } else {
                lo = mid;
                best = a;
            }
        }
        v = lo;
    }
    *s_out = s;
    *l_out = LIFT_MIN + (1.0 - LIFT_MIN) * v;
    *out = best;
    return true;
}

// --- tripode ou vague ----------------------------------------------------------

Gait* Hexapod::wanted_gait() {
    if (wave_mode == WAVE_OFF) return &tripod;
    if (wave_mode == WAVE_ON) return &wave;
    // Automatique, d'après la consigne demandée (pas celle suivie).
    const GaitCommand& c = command;
    if (c.is_zero()) return six;  // arrêt : on finit dans la démarche en cours
    if (!wave_key_valid_ || wave_key_[0] != c.vx || wave_key_[1] != c.vy || wave_key_[2] != c.yaw_rate) {
        wave_key_[0] = c.vx;
        wave_key_[1] = c.vy;
        wave_key_[2] = c.yaw_rate;
        wave_key_[3] = foot_speed(c);
        wave_key_valid_ = true;
    }
    if (six == &wave) return wave_key_[3] > wave_speed ? (Gait*)&tripod : (Gait*)&wave;
    return wave_key_[3] < WAVE_BACK * wave_speed ? (Gait*)&wave : (Gait*)&tripod;
}

void Hexapod::wave_sway(double dt, bool moving) {
    // Décalage du corps à 6 pattes : en vague et en marche, à l'opposé de la
    // patte en l'air ; sinon il revient au centre.
    Gait* g = gait;
    double amp = shift_amp_;
    bool on = g == &wave && moving;
    if (!on && amp == 0.0) return;  // corps au centre : rien à faire (tripode, arrêt)
    amp = shift_amp_ = approach(amp, on ? 1.0 : 0.0, dt / SHIFT_TIME);
    // Réglage changé en marche : suivi à 15 mm/s au plus.
    shift_mm_ = approach(shift_mm_, wave_shift, WAVE_SHIFT_MAX * dt / SHIFT_TIME);
    if (g == &wave) {
        // Chaque patte « attire » le décalage autour du milieu de son pas, de 1/6
        // de cycle avant à 1/6 après : deux pattes à la fois, somme des parts = 1.
        double x = 0.0, y = 0.0;
        double phase = g->phase;
        for (int i = 0; i < 6; i++) {
            double d = pymod(phase - (i + 0.5) / 6 + 0.5, 1.0) - 0.5;
            if (d < 0.0) d = -d;
            if (d < 1.0 / 6) {
                double u = d * 6.0;
                double a = 1.0 - u * u * (3 - 2 * u);
                x -= a * CFG_WAVE_DIRS[i][0];
                y -= a * CFG_WAVE_DIRS[i][1];
            }
        }
        shift_dir_[0] = x;
        shift_dir_[1] = y;
    }
    double k = shift_mm_ * amp * amp * (3 - 2 * amp);
    g->shift_x = shift_dir_[0] * k;
    g->shift_y = shift_dir_[1] * k;
}

double Hexapod::foot_speed(const GaitCommand& c) const {
    // Vitesse du pied posé le plus rapide (en tournant, ceux de l'extérieur).
    double speed = 0.0;
    for (int n = 0; n < NLEGS; n++) {
        double vx = -(c.vx - c.yaw_rate * neutral[n][1]);
        double vy = -(c.vy + c.yaw_rate * neutral[n][0]);
        double v = sqrt(vx * vx + vy * vy);
        if (v > speed) speed = v;
    }
    return speed;
}

void Hexapod::switch_gait(Gait* next) {
    // Les 6 pieds posés restent où ils sont ; la nouvelle démarche commence par
    // lever le pied (ou le trépied) qui a le plus reculé. Le corps garde sa
    // vitesse : la consigne suivie repart de celle que l'ancienne démarche tenait.
    current = command_in_reach();
    const GaitCommand& cmd = current;
    int first = -1;
    double most = 1e-9;
    for (int n = 0; n < NLEGS; n++) {
        double vx = -(cmd.vx - cmd.yaw_rate * neutral[n][1]);
        double vy = -(cmd.vy + cmd.yaw_rate * neutral[n][0]);
        double d = (offsets[n][0] - home[n][0]) * vx + (offsets[n][1] - home[n][1]) * vy;
        if (d > most) {
            first = n;
            most = d;
        }
    }
    if (next == &wave)
        next->phase = first >= 0 ? CFG_LEGS[first].wave_rank / 6.0 : 0.0;
    else
        next->phase = (first < 0 || CFG_LEGS[first].tripod_a) ? 0.0 : 0.5;
    next->shift_x = gait->shift_x;
    next->shift_y = gait->shift_y;
    gait = six = next;
    // Pieds « en l'air » à 0 % de leur pas (pas encore levés) : oubliés.
    memset(has_lift_, 0, sizeof(has_lift_));
    memset(has_ground_lift_, 0, sizeof(has_ground_lift_));
    memset(placed_, 0, sizeof(placed_));
    memset(touched_, 0, sizeof(touched_));
    rest_key_valid_ = false;
}

bool Hexapod::feet_settled() const {
    for (int n = 0; n < NLEGS; n++) {
        if (!walking(n)) continue;  // 4 pattes : celles du milieu sont repliées
        const double *o = offsets[n], *h = home[n], *g = home_goal[n];
        if (py_sq(o[0] - h[0]) + py_sq(o[1] - h[1]) > STOP_TOL * STOP_TOL) return false;
        if (replace_feet && py_sq(h[0] - g[0]) + py_sq(h[1] - g[1]) > HOME_REPLACE * HOME_REPLACE) return false;
    }
    return true;
}

// --- place des pieds selon la pose ------------------------------------------

static double py_degrees(double x) { return x * (180.0 / PY_PI); }   // math.degrees
static double py_radians(double x) { return x * (PY_PI / 180.0); }   // math.radians

bool Hexapod::refresh_home() {
    const BodyPose &p = pose, &b = base_pose;
    double key[6] = {p.x - b.x, p.y - b.y, p.z - b.z, py_degrees(p.roll - b.roll), py_degrees(p.pitch - b.pitch),
                     py_degrees(p.yaw - b.yaw)};
    if (home_checked_valid_ && legs == home_checked_legs_) {
        bool same = true;
        for (int i = 0; i < 6 && same; i++) same = key[i] == home_checked_[i];
        if (same) return false;  // rien n'a changé depuis le dernier tour complet
    }
    for (int n = 0; n < NLEGS; n++) {
        if (!walking(n)) continue;
        double m = fabs(key[0] - home_key_[n][0]);
        for (int i = 1; i < 6; i++) m = pymax(m, fabs(key[i] - home_key_[n][i]));
        if (m <= HOME_POSE_MM) continue;
        memcpy(home_key_[n], key, sizeof(key));
        BodyPose q = body_pose(key[0], key[1], key[2], py_radians(key[3]), py_radians(key[4]), py_radians(key[5]));
        double r = best_radius(n, q);
        home_goal[n][0] = r * radial_[n][0];
        home_goal[n][1] = r * radial_[n][1];
        return true;
    }
    memcpy(home_checked_, key, sizeof(key));
    home_checked_legs_ = legs;
    home_checked_valid_ = true;
    return false;
}

double Hexapod::best_radius(int leg, const BodyPose& q) {
    double want = home_target_[leg];
    double f0 = home_margin(leg, q, 0.0);
    if (f0 >= want) return 0.0;
    double lo = HOME_RANGE_LO, hi = HOME_RANGE_HI;
    double out = home_margin(leg, q, HOME_STEP), inside = home_margin(leg, q, -HOME_STEP);
    if (pymax(out, inside) <= f0) return 0.0;  // le neutre est déjà le mieux
    double sign = out >= inside ? 1.0 : -1.0;
    double r = sign * HOME_STEP, f = pymax(out, inside);
    double prev_r = 0.0, prev_f = f0;
    while (f < want) {
        double nr = r + sign * HOME_STEP;
        if (nr < lo || nr > hi) return r;
        double nf = home_margin(leg, q, nr);
        if (nf <= f) return r;  // plus rien à gagner plus loin
        prev_r = r;
        prev_f = f;
        r = nr;
        f = nf;
    }
    return prev_r + (r - prev_r) * (want - prev_f) / (f - prev_f);
}

double Hexapod::home_margin(int leg, const BodyPose& q, double r) {
    const double* p = neutral[leg];
    double ux = radial_[leg][0], uy = radial_[leg][1];
    double x0 = p[0] + r * ux, y0 = p[1] + r * uy;
    double h = 0.35 * tripod.max_stride;  // pied posé : un peu moins d'un demi-pas autour
    double worst = 1e9;
    const double ks[4][2] = {{0.0, 0.0}, {h, 0.0}, {-h, 0.0}, {0.0, gait->step_height}};
    Rot R = rotation(q.roll, q.pitch, q.yaw);
    for (int i = 0; i < 4; i++) {
        double k = ks[i][0], dz = ks[i][1];
        double foot[3] = {x0 + k * ux, y0 + k * uy, p[2] + dz};
        double lf[3];
        foot_to_leg(foot, q, R, leg, lf);
        LegAngles a;
        if (!leg_ik(lf[0], lf[1], lf[2], &a)) return -1e9;
        worst = pymin(worst, leg_margin(g_legs[leg], a));
    }
    return worst;
}

void Hexapod::reach_table(int leg) {
    const double* p = neutral[leg];
    const LegDef& d = CFG_LEGS[leg];
    double dist[REACH_DIRS];
    for (int i = 0; i < REACH_DIRS; i++) {
        double a = 2 * PY_PI * i / REACH_DIRS;
        double ux = cos(d.mount_angle + a), uy = sin(d.mount_angle + a);
        // ok(d) : pied à d mm dans cette direction, servos loin des butées.
        struct Ok {
            static bool at(int leg, const double* p, double ux, double uy, double dd) {
                double foot[3] = {p[0] + dd * ux, p[1] + dd * uy, p[2]};
                const LegDef& d = CFG_LEGS[leg];
                double ex = foot[0] - d.mount_x, ey = foot[1] - d.mount_y;
                double x = d.cos_a * ex + d.sin_a * ey, y = -d.sin_a * ex + d.cos_a * ey;
                LegAngles ang;
                if (!leg_ik(x, y, foot[2], &ang)) return false;
                return leg_margin(g_legs[leg], ang) >= REACH_MARGIN && fabs(ang.coxa * DEG_PER_RAD) <= REACH_COXA;
            }
        };
        double lo = 0.0, hi = REACH_MAX;
        if (Ok::at(leg, p, ux, uy, hi)) {
            dist[i] = hi;
            continue;
        }
        for (int k = 0; k < 8; k++) {
            double mid = (lo + hi) / 2;
            if (Ok::at(leg, p, ux, uy, mid))
                lo = mid;
            else
                hi = mid;
        }
        dist[i] = lo;
    }
    int half = REACH_DIRS / 2;
    for (int i = 0; i < REACH_DIRS; i++) reach_[i] = pymin(dist[i], dist[(i + half) % REACH_DIRS]);
}

double Hexapod::half_stride(int leg, double vx, double vy) const {
    const Gait& g = *gait;
    if (gait == &gait4) return g.max_stride / 2;  // à 4 pattes : le balancement prend de la place
    double speed = sqrt(vx * vx + vy * vy);
    if (speed < 1e-6) return g.max_stride / 2;
    double a = pymod(atan2(vy, vx) - CFG_LEGS[leg].mount_angle, 2 * PY_PI) * REACH_DIRS / (2 * PY_PI);
    long ia = (long)a;
    int i = (int)(ia % REACH_DIRS);
    double f = a - ia;
    const double* t = reach_;
    double base = g.max_stride / 2;
    double extra = pymax(0.0, t[i] + (t[(i + 1) % REACH_DIRS] - t[i]) * f - base);
    return base + extra * reach_share();
}

double Hexapod::reach_share() const {
    const BodyPose &p = pose, &b = base_pose;
    double deg = DEG_PER_RAD;
    double vals[6] = {fabs(p.x - b.x), fabs(p.y - b.y), fabs(p.z - b.z), 2 * deg * fabs(p.roll - b.roll),
                      2 * deg * fabs(p.pitch - b.pitch), 2 * deg * fabs(p.yaw - b.yaw)};
    double worst = vals[0];
    for (int i = 1; i < 6; i++) worst = pymax(worst, vals[i]);
    return pymax(0.0, 1.0 - worst / REACH_POSE);
}

GaitCommand Hexapod::command_in_reach() {
    const Gait& g = *gait;
    const GaitCommand& cmd = current;
    const BodyPose &p = pose, &b = base_pose;
    double key[12] = {cmd.vx, cmd.vy, cmd.yaw_rate, g.stance_time(), g.max_stride, (double)legs, p.x - b.x,
                      p.y - b.y, p.z - b.z, p.roll - b.roll, p.pitch - b.pitch, p.yaw - b.yaw};
    if (reach_cache_valid_ && reach_cache_gait_ == gait) {
        bool same = true;
        for (int i = 0; i < 12 && same; i++) same = key[i] == reach_cache_key_[i];
        if (same) return reach_cache_out_;
    }
    double k = 1.0;
    for (int n = 0; n < NLEGS; n++) {
        if (!walking(n)) continue;
        // ground_velocity(neutral, cmd)
        double vx = -(cmd.vx - cmd.yaw_rate * neutral[n][1]);
        double vy = -(cmd.vy + cmd.yaw_rate * neutral[n][0]);
        double half = halves_[n] = half_stride(n, vx, vy);
        double step = sqrt(vx * vx + vy * vy) * g.stance_time();
        if (step > 1e-9) k = pymin(k, 0.9 * 2 * half / step);
    }
    GaitCommand out = k >= 1.0 ? cmd : gait_command(cmd.vx * k, cmd.vy * k, cmd.yaw_rate * k);
    memcpy(reach_cache_key_, key, sizeof(key));
    reach_cache_gait_ = gait;
    reach_cache_out_ = out;
    reach_cache_valid_ = true;
    return out;
}

void Hexapod::plan_sway(int slot, double* out_x, double* out_y) {
    // Décalage du corps avant le pas de la patte n° slot (QUAD_ORDER) : à `sway`
    // mm à l'intérieur du triangle des 3 pieds qui restent au sol.
    const Gait& g = *gait;
    int lifted = CFG_QUAD_ORDER[slot];
    int partner = CFG_LEGS[lifted].diagonal;
    int ab[2];
    int nab = 0;
    for (int i = 0; i < 4; i++) {
        int n = CFG_QUAD_ORDER[i];
        if (n != lifted && n != partner && nab < 2) ab[nab++] = n;
    }
    GaitCommand cmd = command_in_reach();
    double dt = g.period / 4;
    double f[3][4];  // a, b, partenaire : x0, y0, x1, y1
    const int which[3] = {ab[0], ab[1], partner};
    for (int i = 0; i < 3; i++) {
        int n = which[i];
        const double* p = neutral[n];
        double x = p[0] + offsets[n][0], y = p[1] + offsets[n][1];
        double vx = -(cmd.vx - cmd.yaw_rate * y), vy = -(cmd.vy + cmd.yaw_rate * x);
        f[i][0] = x;
        f[i][1] = y;
        f[i][2] = x + vx * dt;
        f[i][3] = y + vy * dt;
    }
    double a0x = f[0][0], a0y = f[0][1], b0x = f[1][0], b0y = f[1][1];
    double ex = b0x - a0x, ey = b0y - a0y;
    double e = sqrt(ex * ex + ey * ey);
    double nx = -ey / e, ny = ex / e;
    double px = f[2][0], py = f[2][1];
    if (nx * (px - a0x) + ny * (py - a0y) < 0) {
        nx = -nx;  // normale tournée vers le pied opposé
        ny = -ny;
    }
    const double q[4][2] = {{f[0][0], f[0][1]}, {f[0][2], f[0][3]}, {f[1][0], f[1][1]}, {f[1][2], f[1][3]}};
    double m = nx * q[0][0] + ny * q[0][1];
    for (int i = 1; i < 4; i++) m = pymax(m, nx * q[i][0] + ny * q[i][1]);
    double need = gait4.sway + m;
    need = pymax(0.0, pymin(gait4.sway, need));
    *out_x = nx * need;
    *out_y = ny * need;
}

void Hexapod::move_feet(double dt) {
    Gait& g = *gait;
    GaitCommand cmd = command_in_reach();
    bool rest = cmd.is_zero() && g.at_rest() && load_settled_;
    if (rest && rest_key_valid_ && rest_key_gait_ == gait && rest_key_legs_ == legs && rest_key_phase_ == g.phase) {
        // Immobile, tous les pieds posés, et déjà calculé une fois ainsi : rien ne bouge.
        travel[0] = travel[1] = travel[2] = 0.0;
        for (int n = 0; n < NLEGS; n++)
            if (legs == 4 && CFG_LEGS[n].tucked) offsets[n][0] = offsets[n][1] = offsets[n][2] = 0.0;
        return;
    }
    double cvx = cmd.vx, cvy = cmd.vy, yaw = cmd.yaw_rate;
    double st2 = g.stance_time() / 2;
    int stance[NLEGS];
    double swings[NLEGS];
    bool down[NLEGS];
    int nstance = 0;
    for (int n = 0; n < NLEGS; n++) {
        if (!walking(n)) continue;
        double dx = offsets[n][0], dy = offsets[n][1];
        const double* p = neutral[n];
        double s = swings[n] = g.swing(n);
        if (s <= 0.0) {  // au sol (ou à 0 % de son pas, pas encore levé)
            placed_[n] = false;
            if (has_lift_[n]) {
                has_lift_[n] = false;
                has_ground_lift_[n] = false;
                if (touched_[n]) {
                    touched_[n] = false;  // déjà posé (sur un caillou) : il reste où il est
                } else {
                    // Il vient de se poser : il finit son pas sur le point visé.
                    double hx = home[n][0], hy = home[n][1];
                    dx = hx - (yaw * p[1] - cvx) * st2;
                    dy = hy + (cvy + yaw * p[0]) * st2;
                    offsets[n][0] = dx;
                    offsets[n][1] = dy;
                    offsets[n][2] = 0.0;
                }
            }
            stance[nstance++] = n;
        } else {
            if (touched_[n]) {
                // Posé sur ce qu'il a touché : il recule avec le sol comme un pied d'appui.
                if (!has_lift_[n]) {
                    has_lift_[n] = true;
                    lift_[n][0] = dx;
                    lift_[n][1] = dy;
                }
                if (s > 0.0 && !placed_[n]) {
                    placed_[n] = true;
                    home[n][0] = home_goal[n][0];
                    home[n][1] = home_goal[n][1];
                }
                stance[nstance++] = n;
                continue;
            }
            // En l'air : de là où il s'est levé jusqu'à un demi-pas en avant.
            if (!has_lift_[n]) {
                has_lift_[n] = true;
                lift_[n][0] = dx;
                lift_[n][1] = dy;
            }
            double lx = lift_[n][0], ly = lift_[n][1];
            if (s > 0.0 && !placed_[n]) {
                placed_[n] = true;
                home[n][0] = home_goal[n][0];  // il se pose à sa meilleure place
                home[n][1] = home_goal[n][1];
            }
            double hx = home[n][0], hy = home[n][1];
            double tx = hx - (yaw * p[1] - cvx) * st2, ty = hy + (cvy + yaw * p[0]) * st2;
            double k = s * s * (3 - 2 * s);
            // Il redescend vers le sol prévu (le plan des pieds).
            if (!has_ground_lift_[n]) {
                has_ground_lift_[n] = true;
                ground_lift_[n] = ground[n];
            }
            ground[n] = ground_lift_[n] * (1.0 - k);
            // Levée : vitesse verticale nulle au décollage et au poser.
            double u = 4.0 * s * (1.0 - s);
            double z = g.step_height * u * u;
            offsets[n][0] = lx + (tx - lx) * k;
            offsets[n][1] = ly + (ty - ly) * k;
            offsets[n][2] = z;
        }
    }
    // Ce que chaque patte porte (appoint SAG) : tout au sol, rien au milieu de
    // son pas, fondu au début et à la fin du pas.
    for (int n = 0; n < NLEGS; n++) down[n] = false;
    for (int i = 0; i < nstance; i++) down[stance[i]] = true;
    bool settled = true;
    double lstep = SAG_RATE * dt;
    for (int n = 0; n < NLEGS; n++) {
        if (!walking(n)) continue;
        double w;
        if (down[n]) {
            w = 1.0;
        } else {
            double s = swings[n];
            if (s < SAG_FADE) {
                double u = s / SAG_FADE;
                w = 1.0 - u * u * (3 - 2 * u);
            } else if (s > 1.0 - SAG_FADE) {
                double u = (s - (1.0 - SAG_FADE)) / SAG_FADE;
                w = u * u * (3 - 2 * u);
            } else {
                w = 0.0;
            }
        }
        w = load[n] = approach(load[n], w, lstep);
        if (w != 1.0) settled = false;
    }
    load_settled_ = settled;
    // Au sol, les pieds reculent à la vitesse du corps (même réduction pour tous).
    double moves[NLEGS][2];
    double k = 1.0;
    for (int i = 0; i < nstance; i++) {
        int n = stance[i];
        double dx = offsets[n][0], dy = offsets[n][1];
        const double* p = neutral[n];
        double x = p[0] + dx, y = p[1] + dy;
        double vx = yaw * y - cvx, vy = -cvy - yaw * x;
        moves[n][0] = vx * dt;
        moves[n][1] = vy * dt;
        // Pied déjà posé sur un caillou en fin de pas : il se lève au prochain cycle.
        double lift = swings[n] < 0.0 ? g.time_to_lift(n) : 0.0;
        double hx = home[n][0], hy = home[n][1];
        double half = halves_[n];
        if (lift > dt) {
            k = pymin(k, fraction_inside(dx - hx, dy - hy, vx * lift, vy * lift, half));
        } else {
            half += sqrt(vx * vx + vy * vy) * dt;
        }
        k = pymin(k, fraction_inside(dx - hx, dy - hy, vx * dt, vy * dt, half));
    }
    for (int i = 0; i < nstance; i++) {
        int n = stance[i];
        offsets[n][0] = offsets[n][0] + moves[n][0] * k;
        offsets[n][1] = offsets[n][1] + moves[n][1] * k;
        offsets[n][2] = 0.0;
    }
    if (nstance) {
        travel[0] = cmd.vx * k * dt;
        travel[1] = cmd.vy * k * dt;
        travel[2] = cmd.yaw_rate * k * dt;
    } else {
        travel[0] = travel[1] = travel[2] = 0.0;
    }
    for (int n = 0; n < NLEGS; n++)
        if (legs == 4 && CFG_LEGS[n].tucked) offsets[n][0] = offsets[n][1] = offsets[n][2] = 0.0;
    rest_key_valid_ = rest;
    rest_key_gait_ = gait;
    rest_key_legs_ = legs;
    rest_key_phase_ = g.phase;
}

void Hexapod::write_servos(const AngleSet& angles) {
    // Angle servo de chaque articulation (= ik_to_servo_deg, constantes gardées).
    bool batch = driver->has_batch();
    double deg[CFG_NBOARDS][16];
    bool have[CFG_NBOARDS][16];
    int board_order[CFG_NBOARDS];
    int nboards = 0;
    memset(have, 0, sizeof(have));
    for (int i = 0; i < NLEGS; i++) {
        const Leg& leg = g_legs[i];
        const double v3[3] = {angles.leg[i].coxa, angles.leg[i].femur, angles.leg[i].tibia};
        for (int j = 0; j < 3; j++) {
            const JointServo& js = leg.joint[j];
            double d = js.k7 + js.k8 * v3[j];
            d = d < js.min_deg ? js.min_deg : d > js.max_deg ? js.max_deg : d;
            if (js.k9 != 0.0) d = d + (d - js.k10) * js.k9;  // course réelle du servo (TRAVEL)
            if (!batch) {
                driver->set_angle(js.board, js.channel, d);
                continue;
            }
            bool known = false;
            for (int b = 0; b < nboards; b++) known = known || board_order[b] == js.board;
            if (!known) board_order[nboards++] = js.board;
            deg[js.board][js.channel] = d;
            have[js.board][js.channel] = true;
        }
    }
    // Voies qui se suivent sur une carte : une seule écriture I²C.
    for (int b = 0; b < nboards; b++) {
        int board = board_order[b];
        int start = -1, len = 0;
        double run[16];
        for (int ch = 0; ch < 16; ch++) {
            if (!have[board][ch]) continue;
            if (len && ch != start + len) {
                driver->set_angles(board, start, run, len);
                len = 0;
            }
            if (!len) start = ch;
            run[len++] = deg[board][ch];
        }
        if (len) driver->set_angles(board, start, run, len);
    }
}
