Floriantoine/SPY-BOT/hexapod/servo.py

"""Conversion angles IK -> angles servo, et pilotes PCA9685."""

import math

from .config import I2C_ADDRESSES, US_PER_DEG

DEG_PER_RAD = 180.0 / math.pi


def ik_to_servo_deg(angle_rad, joint):
    """Angle servo (0..180°) pour un angle articulaire IK, borné aux limites."""
    deg = 90.0 + joint.direction * (angle_rad * DEG_PER_RAD - joint.zero_deg) + joint.trim_deg
    deg = max(joint.min_deg, min(joint.max_deg, deg))
    if joint.us_per_deg != US_PER_DEG:
        # Course réelle du servo : l'écart à la pose de calibration est mis à l'échelle.
        deg = deg + (deg - 90.0 - joint.trim_deg) * (joint.us_per_deg / US_PER_DEG - 1.0)
    return deg


# Sauts de consigne adoucis (SLEW) : un servo qui doit rejoindre une cible
# éloignée part et arrive en douceur, sans jamais accélérer plus que ça.
SLEW_DEG = 1500.0  # °/s² ; 30° en 0,3 s
SLEW_MAX = 20000.0


def soft_step(e0, w, accel, dt):
    """Un tick du retour vers 0 d'un écart `e0` (non nul), à l'accélération
    `accel` au plus : `w` = vitesse du tick d'avant. Retourne (écart, vitesse).
    Jamais de dépassement, jamais d'éloignement ; arrivée freinée."""
    d = e0 if e0 > 0.0 else -e0
    s = -1.0 if e0 > 0.0 else 1.0
    wd = w * s  # vitesse d'approche en cours
    if wd < 0.0:
        wd = 0.0
    cap = wd + accel * dt
    h = accel * dt / 2
    vc = math.sqrt(h * h + 2 * accel * d) - h  # au-delà, plus moyen de freiner à temps
    lin = d / dt
    if lin <= vc and lin <= cap:
        return 0.0, s * lin  # arrivé à ce tick
    w1 = s * (vc if vc < cap else cap)
    return e0 + w1 * dt, w1


class SmoothDriver:
    """Entre le robot et le pilote des servos : adoucit les sauts de consigne.

    Les consignes de la marche passent telles quelles (aucun retard : les
    pas gardent leur rythme). Tout le reste (changement de pose de
    calibration, test, se lever, pattes repliées...) est suivi exactement tant que
    l'accélération demandée reste sous `accel` ; un saut est rejoint en
    douceur. Un écart encore à rattraper quand la marche commence se résorbe
    par-dessus la marche. Les consignes sont envoyées par flush(), une fois
    par tick. Un servo dont la position est inconnue (relâché) reçoit sa
    première consigne telle quelle.
    """

    def __init__(self, driver):
        self.driver = driver
        self.accel = SLEW_DEG  # °/s², 0 = pas d'adoucissement
        self.busy = False  # un servo n'est pas encore sur sa consigne
        self._boards = {}  # carte -> {voie: [consigne, envoyé, vitesse, consigne d'avant, nouvelle]}
        self._walking = False
        self._fresh = False

    def set_angle(self, board, channel, deg):
        chans = self._boards.get(board)
        if chans is None:
            chans = self._boards[board] = {}
        st = chans.get(channel)
        if st is None:
            chans[channel] = [deg, deg, 0.0, deg, False]
            self.driver.set_angle(board, channel, deg)
            return
        st[0] = deg
        st[4] = True
        self._fresh = True

    def lag(self, board, channel):
        """Angle envoyé au servo s'il n'est pas encore sur sa consigne, sinon None."""
        st = self._boards.get(board, {}).get(channel)
        return st[1] if st is not None and st[1] != st[0] else None

    def relax(self):
        self._boards = {}
        self.busy = self._fresh = False
        if hasattr(self.driver, "relax"):
            self.driver.relax()

    def flush(self, dt, walking):
        """Envoie les consignes du tick. `walking` : le robot marche (ses
        consignes passent telles quelles)."""
        turn = walking != self._walking
        self._walking = walking
        if dt <= 0.0 or not (self._fresh or self.busy):
            return
        self._fresh = False
        accel = self.accel
        driver = self.driver
        batch = getattr(driver, "set_angles", None)
        busy = False
        for board, chans in self._boards.items():
            dirty = False
            for channel, st in chans.items():
                x, p, w, xp = st[0], st[1], st[2], st[3]
                if not st[4] and p == x and w == 0.0:
                    continue  # sur sa consigne, qui n'a pas changé
                st[4] = False
                if turn and w != 0.0:
                    # La vitesse suivie est celle du servo à l'arrêt, et
                    # l'écart de vitesse avec la consigne en marche.
                    vt = (x - xp) / dt
                    w = w - vt if walking else w + vt
                e0 = p - xp if walking else p - x
                if accel <= 0.0 or e0 == 0.0:
                    p = x
                    w = 0.0
                else:
                    e0, w = soft_step(e0, w, accel, dt)
                    p = x + e0
                if p != x or w != 0.0:
                    busy = True
                st[1], st[2], st[3] = p, w, x
                dirty = True
                if batch is None:
                    driver.set_angle(board, channel, p)
            if dirty and batch is not None:
                # Voies qui se suivent : une seule écriture I²C (comme write_servos).
                order = sorted(chans)
                start = order[0]
                run = []
                for ch in order:
                    if run and ch != start + len(run):
                        batch(board, start, run)
                        start, run = ch, []
                    run.append(chans[ch][1])
                batch(board, start, run)
        self.busy = busy


class DryRunDriver:
    """Pilote factice : mémorise les angles, utile pour les tests et la simulation."""

    def __init__(self):
        self.angles = {}

    def set_angle(self, board, channel, deg):
        self.angles[(board, channel)] = deg


class PCA9685:
    """Une carte PCA9685 (16 sorties PWM) sur un bus I²C MicroPython."""

    MODE1 = 0x00
    PRESCALE = 0xFE
    LED0_ON_L = 0x06

    def __init__(self, i2c, address=0x40, freq=50):
        self.i2c = i2c
        self.address = address
        self.freq = freq
        self._last = {}  # dernière valeur écrite par voie
        self._blocks = {}  # dernières écritures groupées (voie de départ -> octets)
        self._write(self.MODE1, 0x00)
        self.set_freq(freq)

    def _write(self, reg, value):
        self.i2c.writeto_mem(self.address, reg, bytes([value]))

    def _read(self, reg):
        return self.i2c.readfrom_mem(self.address, reg, 1)[0]

    def set_freq(self, freq):
        import time

        prescale = int(25000000.0 / 4096.0 / freq + 0.5) - 1
        old = self._read(self.MODE1)
        self._write(self.MODE1, (old & 0x7F) | 0x10)  # veille pour changer le prescaler
        self._write(self.PRESCALE, prescale)
        self._write(self.MODE1, old)
        time.sleep_us(500)
        self._write(self.MODE1, old | 0xA1)  # redémarrage + auto-incrément
        self.freq = freq

    def set_pulse_us(self, channel, us):
        off = int(us * self.freq * 4096 / 1000000)
        if self._last.get(channel) == off:
            return  # inchangé : moins de trafic I²C, moins de risque de parasite
        self._last.pop(channel, None)  # si l'écriture échoue, on réessaiera
        self._blocks.clear()  # une voie change : les écritures groupées sont à refaire
        data = bytes([0, 0, off & 0xFF, off >> 8])
        self.i2c.writeto_mem(self.address, self.LED0_ON_L + 4 * channel, data)
        self._last[channel] = off

    def set_pulses_us(self, channel, pulses):
        """Plusieurs voies consécutives en une seule écriture I²C (registres
        en auto-incrément) : bien plus rapide que voie par voie sur l'ESP32."""
        k = self.freq * 4096 / 1000000
        data = bytearray(4 * len(pulses))
        for i in range(len(pulses)):
            o = int(pulses[i] * k)
            data[4 * i + 2] = o & 0xFF
            data[4 * i + 3] = o >> 8
        self.write_block(channel, data)

    def write_block(self, channel, data):
        """Écrit les registres de voies consécutives (4 octets par voie),
        sauf s'ils sont identiques à la dernière écriture réussie."""
        if self._blocks.get(channel) == data:
            return  # inchangé
        if self._last:
            self._last.clear()  # écritures voie par voie (calibration) à refaire
        self._blocks.pop(channel, None)  # si l'écriture échoue, on réessaiera
        self.i2c.writeto_mem(self.address, self.LED0_ON_L + 4 * channel, data)
        self._blocks[channel] = data

    def off(self, channel):
        # Bit « full off » : le servo n'est plus alimenté en consigne.
        self._last.pop(channel, None)
        self._blocks.clear()
        self.i2c.writeto_mem(self.address, self.LED0_ON_L + 4 * channel, bytes([0, 0, 0, 0x10]))


class PCA9685Driver:
    """Pilote réel : ESP32 sous MicroPython avec deux PCA9685 sur le même bus I²C.

    Par défaut : SDA = GPIO21, SCL = GPIO22, cartes en 0x40 et 0x41
    (quelle patte sur quelle carte : WIRING dans config.py). Impulsions de hexapod-v2-7697 pour des MG92B :
    1400 µs au milieu, 10 µs par degré, bornées à 600-2200 µs (les butées de
    chaque servo, 30° à 150° au plus, donnent 800 à 2000 µs ; le reste sert
    aux servos dont la course réelle demande plus de 10 µs par degré, TRAVEL).
    """

    def __init__(self, i2c=None, addresses=I2C_ADDRESSES, sda=21, scl=22,
                 center_us=1400, us_per_deg=10.0, min_us=600, max_us=2200):
        if i2c is None:
            from machine import I2C, Pin

            # 400 kHz : toutes les puces du bus le supportent (PCA9685, MPU6050,
            # VL53L1X) ; 4 fois moins de temps pour écrire les 18 servos.
            i2c = I2C(0, sda=Pin(sda), scl=Pin(scl), freq=400000)
        # Une carte absente ne bloque pas le démarrage : ses servos sont
        # ignorés et `missing` la signale au PC.
        self.i2c = i2c  # partagé avec le capteur avant
        self.boards = []
        self.missing = []
        self.errors = 0  # écritures I²C échouées
        for a in addresses:
            try:
                self.boards.append(PCA9685(i2c, a))
            except OSError:
                self.boards.append(None)
                self.missing.append(a)
        self.center_us = center_us
        self.us_per_deg = us_per_deg
        self.min_us = min_us
        self.max_us = max_us

    def set_angle(self, board, channel, deg):
        us = self.center_us + (deg - 90.0) * self.us_per_deg
        us = max(self.min_us, min(self.max_us, us))
        if self.boards[board]:
            try:
                self.boards[board].set_pulse_us(channel, us)
            except OSError:
                # Écriture I²C perdue (parasites des servos) : la consigne
                # suivante, 20 ms plus tard, la remplace.
                self.errors += 1

    def set_angles(self, board, channel, degs):
        """Servos sur des voies consécutives de la même carte : une écriture I²C."""
        b = self.boards[board]
        if not b:
            return
        # Angle -> valeur du registre PCA9685 en une multiplication :
        # off = (center + (deg - 90) × us_per_deg) × freq × 4096 / 10⁶.
        k = b.freq * 4096 / 1000000
        lo, hi = self.min_us * k, self.max_us * k
        a = (self.center_us - 90.0 * self.us_per_deg) * k
        m = self.us_per_deg * k
        n = len(degs)
        data = bytearray(4 * n)
        for i in range(n):
            o = a + degs[i] * m
            o = int(lo if o < lo else hi if o > hi else o)
            data[4 * i + 2] = o & 0xFF
            data[4 * i + 3] = o >> 8
        try:
            b.write_block(channel, data)
        except OSError:
            self.errors += 1

    def relax(self):
        for board in self.boards:
            if not board:
                continue
            for channel in range(16):
                try:
                    board.off(channel)
                except OSError:
                    pass
