Floriantoine/SPY-BOT/tests/test_smooth.py

"""Marche plus douce : poser du pied, démarches, décalage du corps, servos."""

import math
import unittest

from hexapod import BodyPose, GaitCommand, default_config
from hexapod.config import MIDDLE_LEGS, tibia_fold_limit
from hexapod.controller import Controller
from hexapod.gait import QUAD_TUCKED
from hexapod.robot import SAG_DEG, SAG_RATE, WAVE_AUTO, WAVE_OFF, WAVE_ON, Hexapod, angles_ok
from hexapod.servo import SLEW_DEG, DryRunDriver, soft_step
from hexapod.servo import ik_to_servo_deg

DT = 0.02
# Entre deux ticks : un pied posé suit le sol (vitesse du corps), un pied en
# l'air va au plus à ~0,5 m/s (au poser, il rejoint son point de pose, qui
# suit la consigne : quelques mm de plus pendant un freinage).
STANCE_JUMP = 4.0  # mm
SWING_JUMP = 12.0  # mm
SWAY_JUMP = 8.0  # mm : à 4 pattes, le corps se décale en plus


def walk(robot, command, seconds, watch=None):
    robot.command = command
    for _ in range(int(round(seconds / DT))):
        robot.update(DT)
        if watch:
            watch()


class Watch:
    """Vérifie à chaque tick ce qu'une marche doit toujours respecter :
    les pieds posés ne glissent pas (ils bougent tous ensemble, vus du
    corps), aucune cible de pied ne saute, aucun servo ne dépasse sa course
    et aucune pièce n'en touche une autre."""

    def __init__(self, test, robot, where=""):
        self.t, self.r, self.where = test, robot, where
        self.before = robot.foot_targets()
        self.grounded = self._grounded()
        self.gaits = [robot.gait]
        self.worst_slip = self.worst_jump = 0.0
        self.min_down = 6

    def _grounded(self):
        r = self.r
        return set(n for n in r.walking_legs() if r.offsets[n][2] == 0.0 and r.gait.swing(n) in (None, 0.0))

    def __call__(self):
        t, r = self.t, self.r
        after = r.foot_targets()
        now = self._grounded()
        self.min_down = min(self.min_down, len(now))
        both = sorted(self.grounded & now)
        for i in range(len(both)):
            for j in range(i + 1, len(both)):
                d0 = math.dist(self.before[both[i]][:2], self.before[both[j]][:2])
                d1 = math.dist(after[both[i]][:2], after[both[j]][:2])
                self.worst_slip = max(self.worst_slip, abs(d0 - d1))
                t.assertAlmostEqual(d0, d1, delta=0.05, msg=(self.where, both[i], both[j]))
        for n in r.walking_legs():
            jump = math.dist(self.before[n], after[n])
            self.worst_jump = max(self.worst_jump, jump)
            limit = SWING_JUMP if n not in both else SWAY_JUMP if r.legs == 4 else STANCE_JUMP
            t.assertLess(jump, limit, (self.where, n))
        angles = r._written
        t.assertTrue(angles_ok(r.config, angles), self.where)
        for leg in r.config.legs:
            a = angles[leg.name]
            for joint, v in ((leg.coxa, a.coxa), (leg.femur, a.femur), (leg.tibia, a.tibia)):
                d = 90.0 + joint.direction * (math.degrees(v) - joint.zero_deg) + joint.trim_deg
                t.assertEqual(ik_to_servo_deg(v, joint), d, (self.where, leg.name))  # pas en butée
            fold = -math.degrees(a.tibia) - 90.0
            t.assertLess(fold, tibia_fold_limit(math.degrees(a.femur), leg.name in MIDDLE_LEGS), (self.where, leg.name))
        if r.gait is not self.gaits[-1]:
            self.gaits.append(r.gait)
        self.before, self.grounded = after, now


COMMANDS = ((15, 0, 0), (100, 0, 0), (-100, 0, 0), (0, 100, 0), (0, -30, 0), (70, 70, 0), (0, 0, 0.1), (0, 0, 1.0),
            (0, 0, -1.0), (40, 0, 0.3), (-60, 40, -0.5), (10, 5, 0.05), (0, 0, 0))
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
