Floriantoine/SPY-BOT/(commit log)

2026-10-19 Add hexapod inverse kinematics, body IK and tripod gait
    - Leg IK/FK for 3-DOF legs (coxa, femur, tibia), knee-up solution
    - Body IK: translation and roll/pitch/yaw with feet fixed on the ground
    - Tripod gait driven by vx, vy, yaw_rate, stopping with all feet down
    - Servo mapping and PCA9685 driver, dry-run driver for tests
    - matplotlib 3D simulation, unittest suite and CI workflow
    Claude-Session: https://claude.ai/code/session_01XmU2tg6nWk1EtYR5mLrGrE
    [body_ik.py, config.py, gait.py, leg_ik.py, robot.py, servo.py, test_body_ik.py]
2026-10-19 Run on ESP32 under MicroPython and add a 3D PC control app
    - Make hexapod/ MicroPython-compatible (no dataclasses, no math.hypot)
    - Geometry, wiring and servo pulses from SmallpTsai/hexapod-v2-7697,
    with all lengths in one DIMENSIONS dict
    - Controller state machine (relaxed, sit, stand, calibration) with a
    line-based serial protocol and a 0.5 s watchdog
    - main.py firmware loop for the ESP32 with a PCA9685 I2C driver
    - pc/server.py + web page: 3D view, power, stand/sit, drive with speed
    and turn in place, body pose, gait and per-servo trim calibration,
    plus a simulation mode
    - MicroPython smoke test in CI
    Claude-Ses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
2026-10-19 Redesign the PC app with joysticks and add an assembly guide
    - New layout: status bar with link, mode and posture controls, tabbed
    side panel, toasts, mobile layout
    - Analog joysticks for moving and turning in place (mouse, touch),
    keyboard and gamepad support
    - Nicer 3D view: shadows, foot contact markers, front arrow
    - Montage tab: servo labels (board and channel) on the 3D model, wiring
    table and a TEST command that wiggles a single servo
    - docs/MONTAGE.md: step-by-step assembly, wiring and calibration guide
    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
    [config.py, controller.py, micropython_smoke.py, servo.py, test_controller.py]
2026-10-19 Highlight the selected servo in calibration and pick it in 3D
    - Selected servo card with its name, PCA9685 port, trim value and
    -1/-0.5/+0.5/+1 buttons; leg map and joint picker show every trim
    - Tap a joint or segment in the 3D view to select its servo (calibration
    and assembly tabs); other legs are dimmed, the driven segment and a
    pulsing halo mark the selection, and the camera turns to the leg
    - Arrow keys adjust the trim and change joint; on phones the 3D view
    stays visible at the top while tuning
    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
2026-10-19 Model the 3D view on the hexapod-v2-7697 parts
    Cross-shaped chassis, MG92B servos, coxa bracket, two-servo femur and
    truss tibia, scaled from the GEOM lengths. Selection, picking, labels
    and calibration focus work on the new parts.
    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
2026-10-19 Mount the coxa servos inside the body in the 3D view
    The coxa servo sits between the two body plates with its shaft on the
    leg mount, so the thigh starts right at the body edge as on the robot.
    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
2026-10-19 Use an easy-to-check pose for calibration and horn fitting
    CAL now puts every leg with the femur flat and the tibia vertical instead
    of each servo at mid-travel (femur 15 degrees up), so horns can be fitted
    and trims judged by eye or with a square. Servo zero offsets are
    unchanged, so the walking range is the same.
    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
2026-10-19 Merge Activate and Stand up into one posture button
    STAND now powers the servos first when they are off, so the top bar has
    a single button that offers the next step (Se lever / S'asseoir) next
    to Relâcher.
    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
2026-10-19 Soft start, servo limits, pilot mode, foot traces, animations
    - Power-on enables the legs one after another, or blends smoothly from a
    known pose, before sitting (new 'wake' mode; STAND waits for it).
    - Servos commanded past their limits turn red in the 3D view (GEOM now
    carries each servo's zero, direction and limits).
    - Calibration export/import as a JSON file.
    - Landscape phone / fullscreen pilot mode, web manifest and icon;
    'python -m pc.server --lan' serves the app to the local network.
    - Speed presets, foot traces on a floor that scrolls with the commanded
    velocity, and a body animation player/editor (anim.js).
    - Link latency (PING every 2 s) and automatic serial reconnection.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
2026-10-19 Use the user's robot dimensions (parts printed at 150%)
    Measured coxa 45, femur 59, tibia 135 mm and an 87.7 mm body at the
    middle legs; the rest of the reference geometry is scaled by 1.5.
    The sit depth is reduced to 30% of the stance height so the femur
    servos stay inside their range when sitting, with a test for it.
    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
2026-10-19 Démarrer même si une carte PCA9685 est absente
    La carte manquante est signalée au PC (ERR au démarrage) et ses servos
    sont ignorés, au lieu de bloquer tout le programme sur ENODEV.
    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
2026-10-19 Calibration : inverser le sens d'un servo monté à l'envers
    Nouvelle commande INVERT et bouton « Inverser le sens » dans l'onglet
    Calibration ; le sens est enregistré avec les trims, exporté et importé.
    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
    [config.py, controller.py, test_controller.py]
2026-10-19 Marche : pas plus longs
    Pas maximal porté à 0,8 tibia (108 mm), période par défaut 1,4 s et
    préréglages revus pour faire de grands pas plutôt que des pas rapides.
    L'interface envoie ses réglages de démarche dès que le robot démarre.
    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
2026-10-20 Afficher la cause du démarrage de l'ESP32 (OK BOOT …)
    Aide à distinguer une chute de tension d'un simple débranchement.
    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
2026-10-20 ESP32 : ne plus s'arrêter en silence sur une erreur
    Une écriture I²C perdue (parasites des servos) est ignorée et signalée,
    une erreur dans la boucle est envoyée au PC au lieu d'arrêter le
    programme, et le bus I²C passe à 100 kHz.
    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
2026-10-20 Câblage : pattes avant et milieu gauche sur la 1re carte
    0x40 : avant droite, avant gauche, milieu gauche ; 0x41 : milieu droite
    et pattes arrière (choix de l'utilisateur). Docs et interface à jour.
    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
2026-10-31 Marche à 4 pattes
    Nouvelle démarche pas à pas (QuadGait) : les pattes du milieu se
    replient, les 4 pattes des coins se lèvent une à une et le corps se
    décale avant chaque pas pour rester dans le triangle d'appui. Commande
    LEGS 6|4 et choix « 6 pattes / 4 pattes » dans l'onglet Pilotage.
    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
2026-10-31 Marche : démarrer et s'arrêter en douceur
    La consigne de vitesse rejoint la demande avec une accélération limitée
    (250 mm/s²) : les pieds ne sautent plus d'un demi-pas au démarrage ni à
    l'arrêt, avec des pas désormais plus longs.
    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
2026-10-31 Marche : pieds posés qui ne glissent plus, 4 pattes plus stables
    Chaque pied est suivi : au sol il recule exactement à la vitesse du corps,
    en l'air il va de là où il s'est levé jusqu'à son point de pose. À 4 pattes,
    le balancement du corps est calculé d'après la position réelle des pieds.
    La 3D fait défiler le sol d'après les pieds posés.
    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
2026-10-31 Servos : n'écrire une consigne que si elle change
    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
2026-10-31 Posture : tibia vertical pour soulager les servos de fémur
    Le pied se rapproche du corps : bras de levier de 51 mm au lieu de 86 mm.
    Pas jusqu'à 0,6 tibia et assis un peu moins bas pour rester dans la course
    des servos.
    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
2026-11-02 Géométrie de l'araignée V1.5 (cotes Fusion 360)
    Pattes 30/55/94,5 mm, axes de coxa sur un cercle de 78 mm, corps à 50 mm du
    sol tibia vertical. Servos au milieu : fémur à plat, tibia perpendiculaire.
    Limites de repli du tibia relevées dans Fusion, vérifiées par un test ; pas,
    levée, balancement à 4 pattes et réglages du corps ramenés à cette taille.
    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
2026-11-02 Marche fluide : plus de petites pauses
    Au démarrage (surtout à 4 pattes), un pied qui se lèverait tard arrivait au
    bout de sa course et arrêtait net tout le corps. Le corps avance maintenant
    juste assez lentement pour que chaque pied tienne jusqu'à son pas, et la
    consigne garde 10 % de marge en marche régulière. Le chien de garde passe à
    1 s pour qu'une commande en retard ne stoppe plus la marche.
    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
2026-11-02 Vue 3D : vraies pièces de l'araignée V1.5
    Corps, coxa, fémur et tibia exportés de Fusion 360 en position montée et
    affichés tels quels ; le dessin générique reste si les fichiers manquent.
    Coxa limitée à ±38° (pattes voisines et PCA9685).
    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
    [corps.stl, coxa.stl, femur.stl, tibia.stl]
2026-11-03 Coxa : ±60° depuis le déplacement des PCA9685
    Les cartes ne gênent plus ; test ajouté pour que deux pattes voisines ne se
    rapprochent jamais de plus de 70°. Corps 3D mis à jour.
    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
    [corps.stl]
2026-11-03 Coxa : limite logicielle ±55°, réduite fémur levé (vérifié par les tests)
    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
2026-11-04 Capteur avant : détection, balayage, arrêt devant les obstacles, simulation et vue radar
    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
2026-11-04 Capteur avant : zone d'arrêt le long de la trajectoire (courbe comprise), marge plus courte pour slalomer
    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
2026-11-04 Navigation autonome : aller à un point en contournant les obstacles, suivre ce qui est devant (simulation avec personne virtuelle)
    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
2026-11-04 Gyroscope MPU6050 : assiette (filtre complémentaire), auto-équilibrage du corps, pente du sol simulée, horizon artificiel dans l'appli
    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
2026-11-04 Servos jamais en butée : pas moins hauts puis pose du corps réduite quand il le faut
    Une pose du corps (POSE, auto-équilibrage) ajoutée à la marche pouvait
    envoyer un fémur ou un tibia au-delà de sa course (pièces en rouge dans
    l'appli). Avant chaque envoi, le robot vérifie les butées des servos (trim
    compris), le repli du tibia, la coxa près de la plaque et les pattes
    voisines ; si ça ne passe pas, il lève moins les pieds (jusqu'à la moitié),
    puis réduit la pose juste ce qu'il faut, et revient doucement. L'appli
    affiche « Pose du corps réduite » (ligne LIMIT pose 1|0).
    Claude-Session: https://claude.ai/code/session_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
    [controller.py, robot.py, test_limits.py]
2026-11-04 Pieds replacés selon la pose du corps, sol bosselé dans la simulation
    - Chaque pied se pose, le long de sa patte, là où ses servos gardent autant
    de marge avant les butées qu'au neutre pour la pose demandée (corps
    baissé, penché, décalé, auto-équilibrage). Il y va à son prochain pas ; à
    l'arrêt, un pas sur place si un pied est à plus de 8 mm de sa place (pas
    en se levant ni en s'asseyant). Calcul étalé (une patte à la fois, quand
    la pose change). Le filet de sécurité (pas moins hauts, pose réduite)
    reste derrière, il ne sert presque plus.
    - Simulation : TERRAIN 1|0, sol bosselé (la pente sous le robot change en
    marchant) ; ligne B (assiette du corps par r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
2026-11-04 Simulation : terrain accidenté (ondulations, cailloux, trous) sous chaque pied
    Le robot repose sur ses pieds posés (plan des pieds au sol, relevé pour
    qu'aucun ne s'enfonce) : il penche selon le terrain sous eux, un pied
    au-dessus d'un trou reste en l'air. TERRAIN 1 envoie la description
    (TERRAINMAP) et la télémétrie le plan des pieds (G) ; la 3D dessine le
    terrain en relief sous le robot.
    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
2026-11-04 Longueur de pas selon la place de chaque patte
    Tableau calculé au démarrage (une patte, les 6 sont la même pièce) : demi-
    pas possible dans chaque direction, servos à 3° des butées et coxa à ±33°
    au plus (voisines sans contact). La consigne n'est réduite que pour la
    patte la plus limitée : 100 mm/s en ligne droite au lieu de 67, 46°/s sur
    place au lieu de 24. Avec une pose forte, retour progressif au demi-pas de
    la config ; le filet de sécurité reste derrière.
    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
2026-11-04 Arrêt plus court, pilotage au clavier sur toute disposition (Dvorak compris)
    - Au lâcher, freinage plus fort (600 mm/s², 4 rad/s²) : le pied en l'air
    vise sa place ; arrêt dès que tous les pieds sont posés à moins de 20 mm
    de leur place. 0,5 à 0,8 s et au plus un pas après celui en cours (avant :
    1,2 à 1,5 s, 2 à 3 pas). Passage 4/6 pattes sans remettre les pieds au neutre.
    - Clavier : touches repérées par leur position (e.code), donc les mêmes en
    AZERTY, QWERTY et Dvorak, plus les flèches ; l'appli affiche les lettres
    du clavier de l'utilisateur.
    Claude-Session: https://claude.ai/code/session_01XmU2tg6nWk1EtY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
2026-11-04 Clavier : clic sur la 3D pour piloter sans que Vimium ou la recherche rapide prennent les touches
    Le focus va dans un champ invisible (contenteditable, rien n'y est écrit) :
    les extensions de type Vim passent en mode saisie et laissent passer les
    touches. Badge « Clavier actif » sur la 3D.
    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
2026-11-04 Onglets : retour à la ligne au lieu d'un défilement caché (Journal invisible)
    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
2026-11-04 Smooth body motion and add a live measures card
    The body froze for one tick when the stance tripod reached the end of its
    stroke just before the other tripod landed (after a restart), giving a sharp
    forward/back jolt. The foot that lifts this tick may now finish its last
    millimetres. On bumpy terrain the simulated body now rocks onto new feet in
    about 0.15 s instead of instantly, and the 3D view eases the attitude.
    New M telemetry line (real/wanted speed, smallest servo margin, kept
    pose/lift, longest tick) shown in a Mesures card in the Journal tab, with a
    button that copies the last 30 s.
    Claude-Session: https://claude.ai/code/sessi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
2026-11-04 Avoid math.hypot, missing in MicroPython
    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
    [controller.py, robot.py]
2026-11-04 Feel the ground with the gyroscope, and stop when tilted too far
    Without foot switches, the robot now guesses uneven ground from how the body
    rocks (FEEL 1): a descending foot that lifts its corner has hit something and
    stops there; a freshly planted foot whose corner sinks is over a hole and
    extends (up to 25 mm). Fast rocking slows the gait until it settles. On the
    simulated terrain with levelling this lowers the average body tilt from 1.2
    to about 1.0 degrees and the share of planted feet not touching by about a
    quarter, also with gyro noise.
    Safety stop: body tilted beyond 20 degrees stops the robot (TILT 1); it may
    walk again once back under 12 degrees for 1 s (TILT 0).
    The simulated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
    [controller.py, imu.py, micropython_smoke.py, robot.py, terrain.py, test_imu.py, test_terrain.py]
2026-11-04 Gait slow-down uses the smoothed rocking rate
    With uneven ticks (the browser demo runs a 20 ms tick plus a short leftover
    one), the raw simulated gyro rate spiked on the short ticks and kept the gait
    at about 70 % speed on bumpy ground. The governor now uses the same smoothed
    rate as the contact guess, weighted by tick length.
    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
    [controller.py, robot.py, test_imu.py]
2026-11-04 Simulated terrain: rest on the 3 feet that carry the centre
    With 6 planted feet, the least-squares plane raised to the highest foot left
    only one or two feet touching and the rest floating. The robot now rests on
    the tripod whose triangle holds its centre with no other foot sinking in
    (upper hull face), like a real robot; feet outside it may hang over a dip.
    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
2026-11-04 3D terrain: anchor it on a touching foot and follow the plane smoothly
    The terrain mesh was placed at the lowest foot, so a foot stretched over a
    hole (FEEL) pulled the ground down and the other feet floated. The G line
    now names a planted foot that touches and its height offset, and the view
    anchors the terrain on it. The terrain plane is also eased at the same pace
    as the attitude, so the ground no longer lags the tilted world for a moment
    (feet briefly sinking or floating).
    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
    [controller.py]
2026-11-04 3D: feet touch the ground
    The tibia length in the config is measured to the ground contact (bottom of
    the printed foot, where tibia.stl ends), but the view placed the ground a
    further 4.5 mm lower (radius of the generic rubber tip), so every foot hovered
    above its contact ring. The ground is now at the tibia tip, and the generic
    tip sphere is moved so its bottom is that point.
    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
2026-11-04 Fix IK and gait issues found in review
    - 4 -> 6 legs right after stopping: wait for the quad sway to return to the
    centre before counting as at rest (one servo jumped 21.7 deg).
    - 4 legs with the body lowered: tucked middle legs no longer count in
    _feet_settled, so the robot stops stepping and can switch back to 6.
    - FEEL: a foot that touched a rock now stays put on the ground (it slid up
    to 58 mm) and keeps its real height when the step is reduced (5.9 deg jump).
    - _best_radius keeps the neutral place when both neighbours are worse.
    - Safety net last resort keeps the last valid angles instead of jumping back
    to the full requested pose.
    - _fraction_inside: a foot inside its circle ca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
    [robot.py, test_limits.py]
2026-11-04 Fix simulation and IMU issues found in review
    - Real robot: MPU6050.update accepted 3 arguments but the controller passes
    5, so every tick with the IMU fitted crashed after the servos (no
    telemetry, levelling, tilt guard, scanner or nav). Test with a fake I2C bus.
    - Attitude filter uses the full Euler kinematics (yaw while tilted was read
    as roll/pitch: 5 deg error at 0.6 rad/s on a 10 deg slope); the simulated
    gyro now reports body rates including yaw. Accelerometer trust scales with
    dt.
    - 4-leg sway: the terrain and the P line use the body position (gait centre
    plus sway), so planted feet no longer slide over the terrain (57 mm) and the
    3D no longer resyncs on every sway.
    - B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
    [controller.py, imu.py, nav.py, test_imu.py]
2026-11-04 IK: battery and strap fold limits for body hexa v6
    Middle legs cap the tibia fold at 40 deg when the femur is at or below
    -53 deg (battery strap loops); all legs cap it at 30 deg at or below -73.
    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
2026-11-08 ESP32: run at 240 MHz so the 18-servo IK fits the 20 ms loop
    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
2026-11-08 Add PROF command to time each part of the ESP32 loop
    Also compute the body rotation once per solve instead of once per leg.
    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
2026-11-08 ESP32 loop: cut the per-tick work by about 40 % walking, 75 % idle
    - Write each leg's 3 servos in one I2C transaction, I2C at 400 kHz
    - Reuse the last angles when nothing moved (standing still)
    - Cache the reach-limited command and the foot placement check
    - Try a slightly lower step before the full limit search (200 ms spikes)
    - Flatten leg_ok and the fold table lookup (half of the IK time)
    - Telemetry at 10 Hz on the ESP32, single format for the T line
    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
2026-11-08 Servos: one I2C write per PCA9685 board (9 channels) instead of one per leg
    Also keep the last body rotation matrix (usually unchanged).
    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
2026-11-08 ESP32 loop: fewer float objects in the IK, servo output and foot placement
    - leg_ik: length-only terms cached, clamps inlined.
    - leg_ok / leg_margin: limits precomputed in radians per servo (recomputed
    when calibration changes), fold table in radians.
    - solve: body/leg frame transforms written inline (no per-leg tuples).
    - write_servos: servo degrees from cached per-joint constants.
    - _move_feet: standing still after walking no longer recomputes the feet
    every tick (the tripod at rest keeps 3 legs at swing 0, so the old
    shortcut never applied); ground velocity inlined.
    Same angles and servo outputs as before on a 3000-tick scenario (walk,
    turn, pose, feel, 4 legs, trims). About 30 % l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
    [leg_ik.py, robot.py, servo.py, test_robot.py]
2026-11-08 ESP32 loop: machine code for the hot functions, lighter servo output
    - @micropython.native on leg_ik, leg_ok, leg_margin, the fold limit,
    write_servos, Hexapod.solve / _move_feet and PCA9685Driver.set_angles
    (no effect on the PC; MicroPython 1.29 on the ESP32 compiles them).
    - set_angles: degrees to PCA9685 register in one multiply-add, register
    bytes built directly and compared with the last write as one block.
    - leg_margin / leg_ok read the cached joint limits directly.
    - PROF: new 'i2c' figure (time on the bus alone, part of 'servos'), to
    check whether the 400 kHz bus speed is really reached.
    Same angles and servo outputs as before on the 3000-tick scenario, with
    and without the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
2026-11-08 Remove @micropython.native: measured on the ESP32, no gain (IK still ~13 ms)
    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
2026-11-08 firmware_c: generate the C++ robot config from the Python sources
    gen_config.py writes src/robot_config.h (geometry, wiring, servo limits,
    fold limits, gait/robot/controller constants, exact GEOM reply) with
    repr() literals, so the C++ port computes with exactly the same numbers.
    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
2026-11-08 firmware_c: C++ port of the IK, tripod gait, robot and controller
    Hardware-free core (compiles with g++ on the PC): leg/body IK, tripod
    gait, Hexapod (accel/decel, reach table, home replacement, solve_limited
    search, fold and neighbour limits) and the Controller state machine and
    text protocol (same replies and telemetry lines as Python; gyro, front
    sensor, navigation and 4-leg mode answer as absent).
    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
    [controller.cpp, controller.h, driver.h, pyfmt.cpp, pyfmt.h, robot.cpp, robot.h]
2026-11-08 firmware_c: host harness comparing the C++ core with the Python Controller
    compare.py builds the core with g++, plays one long scenario (walking in
    every direction, strong poses, gait changes, calibration, servo tests,
    watchdog, power cycles, random commands) in both, and compares every tick:
    joint angles, servo degrees and text lines. Currently bit-identical.
    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
2026-11-08 firmware_c: ESP32 main loop, PCA9685 driver, NVS calibration, docs
    PlatformIO project (esp32dev, Arduino): 50 Hz loop, same boot lines as
    main.py, PCA9685 boards at 0x40/0x41 (one I2C write per run of channels),
    calibration kept in NVS, restore_calib.py to bring back a MicroPython
    calib.json, and a French README (build, flash, restore, go back to V1).
    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
2026-11-08 firmware_c: fix the ESP32 build (names clashing with Arduino macros)
    Arduino.h defines HALF_PI, sq(), degrees(), radians(), and newlib's
    limits.h defines LINE_MAX: the generated constants, the helper functions
    and the command buffer size are renamed (K_HALF_PI, py_sq, CMD_LINE_MAX...).
    test/check_arduino.sh compiles every source on the PC (gnu++11) with the
    Arduino-ESP32 macros forced in, so this kind of error shows up before an
    ESP32 build. compare.py still reports identical output to Python.
    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
    [Arduino.h, Preferences.h, Wire.h, esp_system.h, gen_config.py, main.cpp, robot.cpp, robot_config.h]
2026-11-08 firmware_c: generate the 4-leg, gyroscope, sensor and navigation constants
    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
2026-11-08 firmware_c: 4-leg gait (QuadGait, tuck, sway) and ground sensing in the robot core
    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
2026-11-08 firmware_c: gyroscope, front sensor and navigation, compared with fake devices
    MPU6050 and VL53L1X drivers behind a small I2C bus interface, attitude
    filter, leveler, ground sensing, governor and tilt guard, scanner and
    obstacle filter, GOTO / FOLLOW / NAV. compare.py now also runs a 4-leg
    scenario and scenarios with a fake I2C bus (same chip model on both
    sides) fed by a small simulated world: lines, servos and every I2C
    transaction must match tick by tick.
    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
2026-11-08 firmware_c: probe the gyroscope and the front sensor on the ESP32 bus
    check_arduino.sh now defines ARDUINO, so main.cpp, pca9685.cpp and
    wire_bus.cpp are really checked (they were skipped before).
    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
    [Arduino.h, esp_system.h, main.cpp, wire_bus.cpp, wire_bus.h]
2026-11-08 firmware_c: rename 'quad' (newlib xtensa defines it as a macro)
    sys/types.h on xtensa does '#define quad quad_t', which broke the ESP32
    build. The 4-leg gait member is now gait4 and the config field quad_rank;
    check_arduino.sh now rejects these reserved names in src/.
    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
    [Arduino.h, controller.cpp, gen_config.py, robot.cpp, robot.h, robot_config.h]
2026-11-09 MOVE: refuse nan and inf (they broke the gait until the next reset)
    A single 'MOVE nan 0 0' (for example a web page sending NaN) put NaN in
    the gait and the odometry: every later tick failed, in Python and in C++,
    until the ESP32 was reset. MOVE now answers 'ERR MOVE : vitesse invalide'.
    Same change in hexapod/controller.py and firmware_c/src/controller.cpp,
    with a unit test and a line in compare.py.
    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
    [compare.py, controller.cpp, controller.py, test_controller.py]
2026-11-09 firmware_c: check more Arduino-ESP32 and newlib names on the PC
    The stub Arduino.h now also has the other macros of Arduino-ESP32 2.0.17
    (DISABLED, ANALOG, OPEN_DRAIN, ONLOW, word(), bitWrite...), the pin
    constants of the esp32 variant (SDA, SCL, T0..T9, A0...), the ctype.h
    macros (_U, _L, _N...), MIN/MAX/HZ/howmany of sys/param.h, BIT() and the
    'xtensa' macro of gcc. check_arduino.sh also refuses the BSD type names
    of sys/types.h (uint, ushort, ulong...) and the binary constants B0..B11111111.
    src/ was compared with the macro names of the real headers (Arduino core
    2.0.17, its ESP-IDF SDK, newlib): no clash left.
    Claude-Session: http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
2026-11-09 LEVEL 0: the correction goes away smoothly instead of in one tick
    Up to 10 degrees of body tilt were removed at once when LEVEL was switched
    off on a slope. Leveler.update now uses the existing relax() (10 deg/s).
    Same change in Python and C++ (the 'capteurs' scenario of compare.py
    already switches LEVEL on and off while walking), with a unit test.
    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
    [imu.cpp, imu.py, test_imu.py]
2026-11-09 Gyroscope: the bias measure restarts while the robot is moved; IMU CAL
    The gyroscope bias was averaged over the first second after boot, whatever
    the robot was doing (carried, or falling on its belly after a reset): a
    wrong bias tilted LEVEL and disturbed FEEL until the next reset. Now the
    1 s window starts again as long as the gyroscope varies by more than
    0.05 rad/s (about 3 deg/s) inside it, and 'IMU CAL' measures the bias again
    on demand. The IMU line gains 'ready 0|1' (bias measured, attitude known).
    Same change in Python and C++; new scenario in compare.py and unit tests.
    Claude-Session: https://claude.ai/code/session_01XmU2tg6n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
    [compare.py, controller.cpp, controller.h, controller.py, gen_config.py, imu.cpp, imu.h, imu.py]
2026-11-09 Gyroscope: after 5 failed reads in a row the attitude is no longer used
    A gyroscope that stopped answering (loose wire) left the last attitude in
    place for ever: LEVEL kept integrating a frozen error up to its 10 degree
    limit and the tilt stop stayed stuck, with nothing said to the PC.
    After 5 consecutive failed reads (0.1 s) the attitude is 'not ready': the
    level correction relaxes smoothly, FEEL and the tilt stop are inactive
    (a pending stop is released with TILT 0), no I lines. At the first good
    read the attitude restarts from the accelerometer, with the same bias.
    main.py and main.cpp report the lost reads like the PCA9685 ones
    ('ERR I2C gyroscope : n lectures perdues', at most once per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
    [compare.py, controller.cpp, controller.py, gen_config.py, imu.cpp, imu.h, imu.py, main.cpp]
2026-11-09 Gyroscope: IMU AXES and IMU ZERO, kept in the robot's memory
    The orientation of the MPU6050 board was a compile-time constant (IMU_AXES)
    and there was no way to remove the reading left on a flat floor: fixing
    either one meant rebuilding and reflashing.
    - 'IMU AXES +y-x+z' : for the front, the left and the top of the robot,
    the board axis that points there and its sign. Anything that is not a
    rotation of the board is refused (gyroscope and accelerometer would
    disagree). The bias is measured again after a change. Default: IMU_AXES.
    - 'IMU ZERO' : robot on a flat floor, the attitude read (minus the pose the
    legs give to the body) becomes the zero; refused if the gyroscope is not
    read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
    [compare.py, controller.cpp, controller.h, controller.py, gen_config.py, host_main.cpp, imu.cpp, imu.h]
2026-11-09 GOTO and FOLLOW stop when nothing comes from the PC for 5 s
    While the robot drove itself the MOVE watchdog was reset at every tick: a
    robot that was following kept walking with the cable unplugged or the
    application closed. A link watchdog now counts the time since the last
    line received (any line, empty ones excepted) and is not reset by the
    navigation: after LINK_TIMEOUT (5 s) GOTO and FOLLOW stop with 'NAV off'.
    The application already sends a PING every 2 s (at most 4 s apart when a
    reply is lost), so it needs no change. The tests and the compare.py
    scenarios now send that PING too, with a link-loss case for both modes.
    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
    [compare.py, controller.cpp, controller.h, controller.py, gen_config.py, robot_config.h, test_nav.py]
2026-11-09 Front sensor: scan at the 100 ms pace of the VL53L1X, longer first wait
    With its default configuration the VL53L1X gives one measure every 100 ms,
    but the scan (and so the simulation) assumed one every 50 ms: the real
    sweep was half as fast as the simulated one. SCAN_PERIOD is now 0.1 s, the
    smallest change (no new register written to a chip never tried yet);
    the real robot already waited for each measure, so only the simulation
    and the size of the measure buffer change (56 instead of 96).
    At probe, the first measure gets at least 0.5 s (250 tries) instead of
    0.2 s: it lasts more than 100 ms on the real chip.
    Claude-Session: https://c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
2026-11-09 App: gyroscope card gets zero, recalibrate and board orientation buttons
    Tab 'Corps', card 'Gyroscope': 'Mettre à zéro' (IMU ZERO), 'Recalibrer'
    (IMU CAL), 'Carte : ¼ de tour' and 'Carte : retournée' (IMU AXES: the two
    buttons walk through the 8 ways of screwing the board flat, always by a
    rotation). The current axes and zero, read from the IMU line, are shown
    under the buttons. Works the same with the simulated robot.
    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
2026-11-09 Docs: gyroscope settings, first-test steps, link watchdog
    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
2026-11-10 Soft foot touchdown: swing height with no vertical speed at lift-off and landing
    The swing height was step_height * sin(pi s): the foot reached the ground
    at its highest vertical speed. It is now step_height * (4 s (1 - s))^2:
    same height at mid-swing, zero vertical speed at both ends. Same change
    in Python and C++ (one sin() less per swinging foot). FEEL and the
    simulated terrain behave as before (checked in simulation: same tilt,
    touches still detected).
    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
2026-11-10 Wave gait for 6 legs (5 feet down), with an automatic mode: WAVE 0|1|AUTO
    WaveGait lifts one leg at a time, going round the body (LR LM LF RF RM
    RR); its cycle is twice the tripod period, like the 4-leg gait. WAVE 1
    always uses it, WAVE 0 (default, as before) the tripod, WAVE AUTO [mm/s]
    the wave while the fastest foot stays under the threshold (20 mm/s) and
    the tripod above, back to the wave under 80 % of it. WALK gives the
    settings and the 6-leg gait in use; the same line is sent when it changes.
    Switching while walking waits for an instant with the 6 feet down (the
    gait is held there for one tick, as for a stop), the new gait first lifts
    the foot that has moved back the most, and the fol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
2026-11-10 Vague : le corps se décale à l'opposé de la patte en l'air (SHIFT)
    En vague (5 pieds au sol), le corps se décale de quelques mm à l'opposé de
    la patte levée : les pattes posées se partagent mieux le poids (patte la
    plus chargée 29,3 % -> 28,3 % du poids à 6 mm, marge des servos en hausse).
    Le décalage glisse d'une patte à la suivante sans à-coup, vient et s'en va
    en 1 s, et il est nul à l'arrêt.
    En tripode il reste nul : le centre des 3 pieds posés est déjà sous le
    corps, et s'en rapprocher ne soulage pas la patte la plus chargée (calcul
    fait). Le décalage à 4 pattes ne change pas.
    Commande SHIFT mm (6 au départ, 0 à 15, 0 = aucun), reprise dans la ligne
    WALK ; curse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
2026-11-10 Appoint des pattes qui portent : fémur baissé de SAG degrés (flexion sous le poids)
    Une patte qui porte fléchit (jeu et souplesse du servo du fémur) : le corps
    descend de quelques mm et retombe à chaque changement d'appui. Les pattes au
    sol poussent donc un peu plus : fémur baissé de SAG degrés (1,5 au départ,
    soit ~2,5 mm au pied).
    - L'appoint suit ce que la patte porte : entier au sol, nul au milieu du
    pas, fondu sur les premiers et les derniers 20 % du pas, jamais plus vite
    que 10 /s ; nul pour une patte repliée (4 pattes) et quand le robot est
    assis (il vient en se levant).
    - Il est ajouté avant le contrôle des butées et du pliage : le filet de
    sécurité en tient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
    [compare.py, controller.cpp, controller.py, gen_config.py, micropython_smoke.py, robot.cpp, robot.h, robot.py]
2026-11-10 Sauts de consigne des servos adoucis (SLEW), pose du corps rejointe en douceur
    Ce qui existait déjà : rampe de vitesse au départ et à l'arrêt de la marche
    (ACCEL/DECEL), servos alimentés patte par patte ou fondu depuis une pose
    connue (WAKE), 2 s pour se lever. Mais une consigne qui changeait d'un coup
    partait telle quelle : POSE, pose de calibration, test d'un servo, trim.
    - SmoothDriver, entre le robot et le pilote des servos : hors marche, chaque
    servo suit sa consigne exactement tant que l'accélération demandée reste
    sous SLEW (°/s², 1500 au départ) ; un saut est rejoint en douceur, sans
    dépassement ni recul (30° en 0,3 s). En marche, les consignes passent
    telles q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
2026-11-10 Course réelle des servos : TRAVEL (µs par degré) et HOLD pour la mesurer
    Le robot envoie 10 µs d'impulsion par degré ; un vrai servo tourne souvent
    un peu plus ou un peu moins. Les trims règlent la pose de calibration, pas
    la course : les poses éloignées étaient fausses de quelques degrés.
    - Chaque servo a son réglage us_per_deg (10 au départ, 8 à 13). L'écart à la
    pose de calibration (90 + trim) est mis à l'échelle après les butées, qui
    restent en degrés réels : les trims restent bons, rien ne change à 10.
    - TRAVEL leg joint us, TRAVEL ALL us, TRAVEL (lit les 18 valeurs).
    - HOLD leg joint deg : en pose de calibration, tient un servo à ±60° au plus
    de cette po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
